hsh3167/amr_project/design_state.md

# AMR 설계 상태 — Rev14

이 문서와 요청에 필요한 소스만 먼저 읽는다. 긴 대화와 전체 저장소를 다시 분석하지 않는다. 실행 방법은 `docs/build123d-workflow.md`, 부품 출처/버전 한계는 `docs/vendor-cad.md`에 있다.

## 구성·좌표

- mm, X오른쪽/Y전방/Z위, 지면Z0. 2WD 차동구동 + 캐스터4개. **Rev12: 6륜 각각 독립 경첩+스프링 서스펜션**(핀 축 +Y, 전후진 대칭). Rev10(시소)·Rev11(레일)은 사용자 결정(2026-11-12: 독립·단순·소형)으로 대체.
- 하판390×530×**t3 강판**/Z117~120, 상판420×550×**t3 강판**/Z283~286(Rev09a: 윗면Z120·상판 밑면Z283 기준 유지), 하판 휠 웰 안쪽 X±175(Rev12, 기존±145), 트랙422, 구동륜 중심X±211/Y0/Z90. 상판은 Rev07 대비 20mm 낮췄다.
- 캐스터 스위블 중심X±138/Y±215, 휠 축Z32/오프셋Y-22. 공식 EUS CAD 장착면Z83. 카탈로그82와 실물 차이 미확인.
- LiDAR: (-220,250),heading-45° / (220,-250),heading135°, 스캔면Z240.83 가정. 광학 원점/ROS TF는 미검증.
- 카메라: X±90/Y278/Z267, yaw±15°/하향10° 가정. 상판과의 여유를 위해 카메라와 어댑터를 8mm 내렸다. Al프로파일8개: 주163mm×4 + LiDAR 지지×2 + 카메라 행거28mm×2(Rev09 구동 서스펜션 지주40mm×4 삭제). 범용20×20 단면.
- 로봇암용 상판/보강/임시124mm 홀 피치는 `payload_interface` 그룹. 6축 암 모델·하중·정격 반력·볼트 패턴은 미선정.

## 구매품

| 부품 | 확인된 사양·데이터 | 한계 |
|---|---|---|
| ZLLG65ASM250-N V2.02 ×2 | 수신23p PDF: Ø180±2, 폭42.5±1, 축방향89.8±1, Ø14/AF10/M14×1.5, NBR. 24V/18–30V,4Nm/500rpm/10A,스톨11.7Nm/30A,1024라인 | 케이스Ø140 가정, 정확한 제조사 STEP 미확보, 사양서 본문/도면표 충돌은 기존 검토문서 유지 |
| GL-65-ASF ×4 | 공식 GL-65-ASF-EUS STEP3솔리드. CAD높이83/판48X×65Y/홀24X×54Y | 보유품 EUS/TUN 및 카탈로그H82와 차이 확인 |
| SICK TiM571-2050101 ×2 | 기구 검토는 공식 치수도 엔벨로프76.25×74.39×101.12,270°,9–28V. 웹 외형은 SICK TiM5xx 공용 STL | 공개 CAD 다운로드는 EPLAN. 품번 1075091의 기구 STEP과 로그인 후 AAS 제공 여부 미확인 |
| Astra Mini Pro MX6000 A V1.2 ×2 | 공식 제품군 STEP V0.1/20221012,58솔리드. 2D V1.2:84.9×20×19.92REF,2×Ø2.2/M2 피치80 | 3D 깊이24.264와 차이. 3개 열린 참고 셸 제외. 구매품 라벨/마운트 확인. STEP 재불러오기 공차 정규화 필요 |

## 구현·설계 결정

- build123d0.12.0/OCP7.9.3.1.1, Python3.10 가상환경 `.venv`. 기존 글로벌 CadQuery2.5.2 환경은 분리 보존.
- `cad/parameters.py`가 공통 JSON을 읽고 `parts/`의 독립 생성 함수, `assembly.py`, `export.py`, CLI `python -m cad`로 조립/출력. `cad/amr_layout.py`는 새 기본 엔진의 호환 진입점.
- `--part`로 필요한 그룹만 생성, `--format none/step/stl/glb` 선택, `--individual` 개별 출력. `param` 명령/JSON 편집은 AI 없이 사용. `--pose LEFT=10`/`RF=-5` 등 6륜 각각(구동 휠 중심±10, 캐스터 장착 중심±5; 경첩 회전).
- 각 모듈: 3t U 절곡 브래킷(하판 밑)+3t 절곡 암+8t 평판 보스(Rev14)+CLBKHM10 핀(귀 고정)+MPFZ10-10 플랜지 무급유 부시2(암 Ø14 H7 압입)+스프링(암↔하판 밑면 직결)+M8 스터드(하판 위 너트=처짐 스토퍼)+C-USLH10 우레탄 스토퍼+M6 받침 볼트(범프 스토퍼, Rev12b)+예압 심. 구동: 핀X±81/Z95, 암130mm(측벽Y±36.5~42.5), CLBKHM10-78.5(Rev12a), X-SWU21-70(X±155/Y−25, 간격45·심5, 레버비0.569), 모터 축 끝벽X±167~173. 캐스터: 핀=캐스터 안쪽90mm/Z99.5, CLBKHM10-75, X-SWU17-35(캐스터 안쪽25mm—주 기둥 회피, 간격28·심5, 레버비0.722), 범프 볼트 안쪽50mm. 용접·레일·베어링·행거 없음, 가공 판금12개(3t)+평판14개 약2.9kg(Rev14). **Rev12a(2026-11-13) 구동 암 소형화:** 트레이 옆벽→핀 날개(핀 앞25)+축 끝벽±20, 암 Y−42.5~+21 비대칭, 범프 볼트 X±130/Y−25, 핀 CLBKHM10-78.5, 브래킷 볼트 Y−25/+5. 구동 암0.87→0.48kg, 모듈 폭108.5→87mm. 높이(스프링·캐스터 스택)와 X 길이는 유지. [구조·치수](docs/suspension-misumi.md) · [BOM](bom/suspension_misumi.csv)
- **Rev14(2026-11-14) 3t 절곡 제한·LiDAR 고정:** 제작 조건 "절곡 3t까지"에 맞춰 서스펜션 암·브래킷을 3t 절곡으로 바꾸고 두꺼운 부분은 평판(8t 보스, 3t 토크판)을 볼트 체결했다. 캐스터 암에 판 위 넓은 패드를 둬 볼트 구멍이 가장자리로 터지던 문제를 없앴다. 볼트는 너트 위 2mm(CB5-12, CB6-12). LiDAR는 단일 볼트 받침 기둥 대신 주기둥 두 면을 감싸는 3t 절곡 브래킷 + T너트 M5 4개로 고정(3g 처짐 0.03mm 계산). 핀·스프링 길이·하중은 그대로. [상세](docs/suspension-misumi.md)
- **Rev13(2026-11-14) 체결·지지 재점검:** 떠 있거나 체결이 없는 부품을 모두 고쳤다. 기둥 8개(주4·LiDAR2·카메라 행거2)는 양끝을 CB5-12로 판을 관통해 프로파일 중심 탭(M5)에 체결하고 하부 코너판(체결 없는 사각판)은 삭제했다. 캐스터 판 볼트 CB6-16은 OEM STEP 실측 판 두께 2mm 밑면에 머리가 닿게 바꿨다(기존 5mm 가정으로 3mm 떠 있었음). LiDAR 받침 기둥을 X±176/Y±220으로 옮겨 브리지가 주기둥을 피하고 받침 기둥에 볼트로 고정된다. 드라이버·PCB·컴퓨터(PCB 위 10mm)·전원부는 M4 스탠드오프, 배터리는 고무 패드 위에 둔다(끈은 미표시). 카메라는 90×74 어댑터판 위 10° 쐐기에 얹는다(M2 나사 미표시). 상판 보강판은 M8 4개로 체결. 검증에 접촉 연결 검사(모든 부품이 하판까지 접촉으로 이어짐, 간격 0.2mm 이하)를 추가했다.
- **Rev12b(2026-11-14) 상세화:** 범프 스토퍼를 MISUMI C-USLH10(우레탄, D10·높이17·M5 나사7)으로 교체해 암에 M5로 고정하고, 하판 관통 M6 볼트가 끝을 받는다(볼트로 높이 조정). 핀·부시·C-USLH10은 MISUMI 제공 STEP 형상을 그대로 조립(`misumi_step_exact`), 스프링은 STEP 사각 선재 단면·피치로 표시. 암 부시 구멍 입구 0.5×45° 모따기, 핀 고정 나사는 M6 탭 최소경으로 체결 표현. 전체 부품 쌍 간섭 검사를 검증에 추가하고, 하부 코너판·LiDAR 브리지·SICK 외곽·스프링 시트 간섭을 고쳤다(Rev05 기준 부품은 그대로). [상세](docs/suspension-misumi.md)
- 설계 질량 55kg(20kg 암 포함)/35kg(암 없음, 심 제거). 추정 접지: 구동127N(108~143, 바퀴 강성1.75N/mm, Rev12a 비현가 추정3.45kg)/캐스터71N(51~87, 3.63N/mm), 55kg 침하+0.7mm, 35kg 심 제거−2.9mm. 끝 기울기 구동4.4°·캐스터3.2°. MISUMI CK68(스프링)·p1_065(CLBKHM D10 L25~100 0.1단위) PDF를 2026-11-12 확인.
- 수직 이동은 기울어지는 힘을 받는 가이드(레일 또는 긴 부시)가 바퀴마다 필요해 복잡하고, 판스프링·볼트 매달기 방식은 비틀림·끼임으로 부적합해 경첩을 채택. Rev09 부시 가이드는 스톨 토크에서 굳을 위험. 2026-11-14 재검토: 핀 축이 진행 방향과 나란해 턱·경사의 앞뒤 힘은 암을 돌리지 않고(수직 이동과 동일), 단점은 좌우 기울기(구동 4.4°·캐스터 3.2°)·캐스터 좌우 이동 3.6mm·옆힘 하중 변화(1N당 0.73/1.1N)다. 수직 가이드는 마찰이 스프링 하중 변화(±18N)보다 커질 수 있어 경첩 유지. [검토](docs/suspension-misumi.md) 모터 축 스택(와셔·M14 너트·4.9mm 시험 스페이서) 유지.
- 구동 서스펜션과 간섭을 피하려 드라이버 공간Y85→125. 나머지 주요 배치는 유지. 전장/배터리는 공간예약 더미.
- 카메라 배치 BRep를 소스/코드/자세 해시별 `output/cache/`에 저장. 원본은 무손실 gzip 보관하고 SHA256 기록. STEP 수치 공차 문제를 숨기지 않고 원본 불러오기와 카메라에 한정한0.00001mm 공차 복원 후 결과를 분리 기록한다.
- FreeCAD는 STEP→검토 FCStd 매크로를 제공한다. 웹 GLB는 선형0.4mm/각도0.35rad에서 같은 부품과 재질의 면을 묶는다. WebGL은 화면이 바뀌거나 주행 애니메이션이 실행될 때 그린다. 캐시 재불러오기 시 솔리드 조립 트리를 복원한다.
- 웹 뷰어에서 LiDAR 수평 270°/사각 90°와 Astra Mini Pro 깊이 58.4°×45.5°를 각각 표시한다. LiDAR는 설계 스캔면, 카메라는 모듈 중심과 공칭 장착각을 사용한다. 표시 길이는 LiDAR 240mm, 카메라 280mm이며 실측 탐지거리와 가림은 별도 검증 대상이다. [Orbbec 사양서](https://www.orbbec.com/wp-content/uploads/2023/04/ORBBEC_Datasheet_Astra-Mini-Pro-1.pdf)

## 검증·기준

- **Rev14(3t 절곡) 178개 부품·413개 솔리드**: 형상 유효성, pytest 18개, Rev05 85개 부품 비교 통과. 정지 자세 320쌍·바퀴 끝 12자세 690쌍·6륜×5자세 474쌍·캐스터 선회 96자세 128쌍 간섭0, 접촉 연결 247접촉·미지지 부품0. 55kg 정적 평형은 Rev12와 같다(침하 +0.7mm, 구동 127N, 캐스터 71N). 강도는 단순 정적 계산만(3g 최대 약 70MPa, 캐스터 판 앞 바닥 단면).
- **Rev13(체결·지지) 156개 부품·355개 솔리드**: 형상 유효성, pytest 17개, Rev05 85개 부품 비교 통과. 정지 자세 254쌍·바퀴 끝 12자세 504쌍·6륜×5자세 326쌍·캐스터 선회 96자세 128쌍 간섭0. 접촉 연결 검사 209접촉, 미지지 부품0(GL-65 포크-판 0.87mm는 OEM STEP에 볼 베어링이 없어 예외 연결). 체결 강도·조임력은 미검증.
- **Rev12b(MISUMI STEP 상세화) 147개 부품·317개 솔리드**: 형상 유효성, pytest 15개(Rev12b 회귀 1개 추가), Rev05 85개 부품 비교 통과. 새 전체 간섭 검사: 정지 자세 전 부품 224쌍, 바퀴별 상하 끝 12자세(스프링·스토퍼 포함) 488쌍 간섭0. 기존 6륜×5자세 326쌍, 캐스터 선회 96자세·128쌍 간섭0. GL-65 제조사 STEP 내부 허브-포크 겹침 26mm³는 예외로 기록. 우레탄 압축·강도·스프링 하중은 계산·실측 검증 전.
- **Rev12a(구동 암 소형화) 141개 부품·305개 솔리드**: 형상 유효성, pytest 14개(Rev12a 회귀 1개 추가), Rev05 85개 부품 비교 통과. 6륜×5자세=30개 표본·326쌍, 캐스터 선회·상하 96자세·128쌍 BRep 간섭0. 새 범프 볼트 위치에서 처짐 너트·범프 볼트 접촉 테스트 통과. 암 강도는 단순 정적 계산(3g 굽힘 약47MPa, 정지 토크 비틀림 약11.5MPa)만.
- **Rev12(부시 추가) 141개 부품·305개 솔리드**: 형상 유효성, 기하 테스트13개, Rev05 85개 부품 양방향 차집합 통과. 6륜×5자세=30개 표본·326쌍, 캐스터 선회·상하 96자세·128쌍 BRep 간섭0. 서스펜션 80부품을 공칭 자세에서 전체 부품과 별도 교차 검사(간섭0). 각 암이 처짐 너트·범프 볼트에 정확히 닿고 넘으면 간섭, 부시는 암과 함께 움직이고 핀과 겹치지 않음을 테스트. STEP 일반 재불러오기 false(카메라)/정규화 후 true. 웹 뷰어 6륜 포즈·오류0. 강도는 단순 계산만. Rev11 레일안 검증은 커밋 5c308b1.
- Rev09 159개 부품·337개 솔리드. 기하 테스트 13개, Rev05 기준 85개 부품 비교, 상하 30개 및 선회·상하 조합 96개 간섭 표본 통과. 로커 양쪽 스토퍼가 설정 범위를 제한하는지 확인했다. 150N 수직·75N 수평의 가정 하중에서 암 단면 단순 휨 약 125MPa. 시제품 충격·피로 검증은 남아 있다.
- CAD 체적과 강철 밀도 7.85g/cm³로 추정한 캐스터 가공 강판 부품은 4개 모서리 합계 약 3.83kg으로 Rev08의 약 2.78kg보다 1.05kg 증가했다. 레일·핀·부시·체결품과 구매 캐스터를 제외한 비교다.
- Rev08 167개 부품·357개 솔리드. 기하 테스트 13개와 Rev05 양방향 차집합 비교 통과. 상하 30개 자세와 캐스터 선회·상하 96개 표본에서 간섭이 없었다. 상판 밑면은 카메라 최고점보다 약 4.32mm 위이고, 최저 카메라 어댑터는 LiDAR 설계 스캔면보다 11.17mm 위다.
- Rev07 전체 191개 부품·365개 솔리드, 서스펜션 단독 STEP 136개 부품. 테스트 12개 통과. 상하 이동 30개와 캐스터 선회·상하 조합 96개 표본에서 간섭 0건. 스프링 길이·변형 여유·하중 추정치는 `build_report.json`의 `suspension_catalog`에 기록한다. [GitHub 자동 생성 결과](https://github.com/hsh3167/amr_project/actions/runs/43217610583)
- 복원 브랜치 `backup/cadquery-rev05-20261111`, 기준 커밋 `61483e8`, `cad/baseline/rev05/` STEP/JSON 보존. `cad/amr_layout_cadquery.py`는 기준 JSON에 고정한 기존 코드. 기존 CadQuery 재생성 통과.
- **순수 엔진 전환85부품:** 이름별 경계/질량중심/체적/솔리드 수/양방향 차집합 모두 통과. 최대 경계오차8.62e-11mm, 체적차2.06e-7mm³, 차집합0mm³. `comparison_build123d.json` 참조.
- 공식 캐스터3솔리드/H83, 6륜 공칭접지와 독립 자세, 개별 STEP 재불러오기와 Rev07 스프링 카탈로그 장착 길이를 자동 검사한다.
- 99개 관련 부품 대상으로 6륜×5자세=30개 표본,84개 후보 쌍의 실제 BRep 교차 검사에서 간섭0. 연속 스위프/스프링 및 접합부 내부 간섭의 전수 검증은 아님.
- Rev05 변환 STEP의85솔리드 유효성/FCStd 저장 완료. **Rev06 117개 논리 부품/231솔리드**의 유효성/양의 체적/6륜 접지/Ø180×42.5/축 AF10·전체89.8/수량2·4·2·2/스캔면 상하 여유/1616개 LiDAR 표본/선별 간섭 검사 통과. 전체 STEP/STL/GLB와117개 개별 STEP/STL 생성 완료.
- STEP 일반 재불러오기 유효성은 **false**. 카메라2개에 한정한 위상 공차0.00001mm 복원 후 **true**,231솔리드 유지, 공차 복원에 의한 체적 변화0. `build_report.json`은 두 결과를 구분한다. 원본 STEP 자체가 모든 프로그램에서 무보정 유효하다고 주장하지 않는다.
- FreeCAD1.1.4에서 Rev06을 GUI/명령행으로 불러와 카메라14솔리드의 위상 공차를 복원한 뒤231솔리드 유효성 확인 및 `output/freecad/amr_review.FCStd` 저장, GUI 검토 이미지 확인 완료. 매크로는 잘못된 다른 부품을 무조건 복구하지 않는다.
- GitHub 자동 생성 [43027928282](https://github.com/hsh3167/amr_project/actions/runs/43027928282) 통과. [공개 뷰어](https://hsh3167.github.io/amr_project/?rev=06)에서 117개 부품 표시, 상판 숨기기, 바퀴별 스트로크 조작과 STEP 다운로드 응답을 확인했다.

## 미해결·다음 작업

1. 시제품 저울로 55kg에서 구동 약128N·캐스터 약71N 확인, 심·스터드 너트·범프 볼트로 조정(암 없으면 심 제거). 부시 압입·핀 고정·축방향 유격, 6t 절곡·구멍 정렬, 범프 충격, 감쇠 부족(댐퍼 없음) 검증. 구동축 숄더·와셔·너트 실제 스택 확인. MISUMI CAD·가격·납기는 2026-11-14 확인: 핀·부시·C-USLH10은 STEP 그대로 조립(Rev12b), MISUMI 품목 합계 212,580원 + 표준품·판금 추정 293,160원 = 서스펜션 예상 505,740원(VAT 별도, 공개 뷰어 BOM). 판금 가공·표준품 견적, 실물 공차·열처리, C-USLH10 우레탄 충격 흡수량은 미확인.
2. 캐스터83/82 차이와 suffix, 카메라3D/2D/보유품 버전·어댑터, 모터 케이싱·배선 실측. 일반 STEP 불러오기에서 카메라 수치 공차를 별도 복원해야 하는 호환성 문제.
3. 다음 단계: 앞 캐스터와 구동륜을 보기 링크로 묶는 구조를 새로 만든다. 사용자가 보유 부품을 제공한 뒤 설계한다(준비 문서 [bogie-link-prep](docs/bogie-link-prep.md)). 현재 Rev14는 그대로 둔다.
4. 7S9P 화학종/셀/BMS/실측 크기·드라이버 선정. 4.2V계7S 완충29.4V는 모터30V까지0.6V만 남음. 회생·클램프·BMS 함께 검토. 모터18–30V를 드라이버 정격으로 간주하지 않음. TiM571 최대28V에는 안정화24V 사용.
5. 3t 하판·상판은 프로파일 보강 없이 강도 부족(상판 163MPa/0.49°, 하판 2g 156MPa). 하판 종방향 레일·상판 2040 프레임을 Rev12 경첩 브래킷·스프링·스토퍼 위치와 함께 배치해야 한다. [판·서스펜션 검토](docs/plate-suspension-review.md)
6. 실제 암 선정 후 지지다각형/전도·상판 휨/접합 강성/동하중 검증. 현재 모델은 제작 승인 상태가 아님.
