hsh3167/amr_project/docs/suspension-misumi.md

# AMR 서스펜션 · Rev14 (6륜 독립 경첩 + 스프링, 3t 절곡 제한)

2026-11-12 사용자 결정: 6개 바퀴 모두 독립 서스펜션이고, 구조는 **단순하고 작아야** 한다. 수직 레일(Rev11)은 기울어지는 힘을 받을 가이드가 바퀴마다 필요해 부품이 많았다. 경첩은 핀 하나가 모멘트를 모두 받으므로 가이드가 필요 없어 가장 단순하다. 이전 개념은 git 이력에 있다: Rev09 `4643d47`, Rev10 `a5f5081`, Rev11 `5c308b1`.

## Rev14 3t 절곡 제한 반영 (2026-11-14)

제작 조건: **절곡은 3t까지만 가능**하다. Rev13의 6t 절곡 암과 4.5t 절곡 브래킷은 만들 수 없어 바꿨다. 두꺼운 부품은 절곡 없는 평판으로 만들어 볼트로 체결한다. 핀(CLBKHM10-78.5/-75)과 MISUMI STEP은 그대로다.

| 부품 | Rev13 | Rev14 |
|---|---|---|
| 구동 암 | 6t 바닥 + 핀 날개 + 끝벽 | 3t 채널: 바닥 + 전체 길이 옆벽 2개 + 끝벽(절곡 3회), Y −44~+22.5, 바닥 Z69~72(스프링 자리 Z72 유지) |
| 캐스터 암 | 6t 바닥 + 날개 2개, 폭 ±30 | 3t: 좁은 바닥(±31.5) + 옆벽 2개(절곡 2회) + 캐스터 판 위 넓은 패드(±37.5). 판 볼트 구멍 가장자리 거리 7mm(Rev13은 구멍이 암 옆면으로 터짐) |
| 부시 자리 | 6t 암에 직접 압입 | 옆벽 안쪽 **8t 평판 보스**(절곡 없음)에 압입, CB4-10 2개로 옆벽에 체결. 보스는 브래킷 귀(핀±12)를 피해 핀에서 18mm 바깥에 나사 |
| 구동축 토크 | 6t 끝벽 슬롯 | 3t 끝벽 + **3t 평판 토크판**(AF10.2 슬롯, 축 너트로 함께 조임) = 6mm, 축 스택 위치 그대로 |
| 힌지 브래킷 | 4.5t U | 3t U(절곡 2회) |
| 스프링 자리 | 6t 바닥 윗면 | 구동: 바닥 Z를 3 올려 그대로. 캐스터: 3t 바닥 + **고정 스페이서 3mm**로 그대로(스프링 길이·하중 변화 없음) |
| 스터드 / 스토퍼 | 6t 탭 | 3t 바닥에 M8 탭 + 나사 고정제(처짐 하중 100N 미만). C-USLH10은 3t 바닥 + M5 너트 4 = 나사 7 |
| 볼트 길이 | CB5-14, CB6-16(너트 위 3~4mm) | CB5-12, CB6-12: 너트 위 2mm |

- 가공 강판 합계 약 2.9kg(구동 암 0.38kg, 캐스터 암 0.29kg, 브래킷 0.08kg, 보스 0.07kg ×2).
- 단순 정적 계산(3g 수직 충격, S355): 구동 암 스프링 위치 굽힘 약 9MPa, 정지 토크 11.7Nm 비틀림 약 28MPa(열린 단면, 축 둘레 0.6°), 캐스터 암 핀 쪽 약 17MPa, 캐스터 판 앞 바닥만 있는 단면 약 70MPa, 보스 CB4 전단 약 24MPa, 3t 귀 지압 약 14MPa. 피로·충격·절곡부 균열·실물 강성은 미검증이다.

## Rev13 캐스터 판 체결 (2026-11-14)

- GL-65 OEM STEP의 판 두께는 2mm(Z81~83, 구멍 Ø7)다. 기존 모델은 5mm로 가정해 CB6-16 머리가 판 밑 3mm에 떠 있었고 선회 레이스 위에 얹혀 있었다. 머리를 판 밑면(Z81)에 붙였다. 판 2 + 암 6 + M6 너트 5 + 나사 3 여유이고, 머리 아래 선회 레이스와 3mm 간격이 있다.

## Rev12b 상세화·간섭 정리 (2026-11-14)

- **범프 스토퍼를 MISUMI `C-USLH10`(경제형 우레탄 스토퍼, 수나사)으로 바꿨다.** D10, 높이 17, M5×0.8 나사 7, 쇼어 A90. 암 바닥(6t)에 M5 탭으로 세우고, 하판을 관통한 M6 볼트(잼너트로 높이 조정)가 끝을 받는다. 우레탄 높이 17로는 암과 하판 사이(구동 45, 캐스터 28)를 채울 수 없어 볼트를 받침으로 남겼다. 나사 7이 6t 암 밑으로 1mm 나온다.
- 핀(CLBKHM10-78.5/-75), 부시(MPFZ10-10), C-USLH10은 MISUMI가 제공한 STEP 형상을 그대로 조립에 넣었다(`misumi_step_exact`). 스프링 STEP은 자유 길이 형상이라 그대로 쓰지 않고, 모델 스프링을 STEP의 사각 선재 단면(구동 3.75×1.875, 캐스터 3.25×1.625)과 피치(감김 8.75/4.75)로 바꿨다. 끝단 연마 코일은 생략했다.
- 핀 끝 M6 탭(최소경 4.92)에 맞춰 고정 나사 CB6-8의 체결부를 최소경으로 그렸다. 부시 슬리브와 플랜지 사이 R0.3 필렛이 암 구멍 모서리와 겹쳐, 암의 부시 구멍 입구에 0.5×45° 모따기를 넣었다.
- 전체 부품 쌍 검사(정지 자세 + 각 바퀴 상하 끝, 스프링 포함)에서 기존 검사가 보지 않던 간섭을 찾아 고쳤다: 하부 코너판이 3t 하판에 1mm 묻힘 → 판 위로 올리고 기둥 구멍(20.4 각)을 뚫음, 코너판과 LiDAR 기둥 겹침 → 27 각으로 축소, LiDAR 브리지가 주기둥을 관통 → 기둥 자리 노치, SICK 광학 외곽과 상부 원판 겹침 → 외곽 높이 3 축소, 자세별 스프링과 예압 심 겹침 → 기울어진 시트의 높은 쪽에 스프링을 맞춤. GL-65 캐스터 제조사 STEP 안에서 바퀴 허브가 포크 다리에 0.2mm 들어가는 겹침(26mm³)은 원본 그대로 두고 예외로 기록했다.
- Rev05 기준 부품(`--variant baseline`)은 바꾸지 않았다.

## Rev12a 소형화 (2026-11-13)

높이는 줄이지 않았다. 캐스터는 캐스터 높이 83 + 암 6 + 스프링 간격 28 = 하판 밑면 117로 고정이다. 구동 스프링은 CK68에서 짧은 형번(X-SWU21-60은 간격 −5.7mm·압축 여유 1.6mm, X-SWR21-45는 −7.4mm·접지하중 약 86~170N)을 검토했으나, 바닥 높이에 따라 구동륜 접지하중이 크게 흔들려 X-SWU21-70을 유지했다. 캐스터 암 단축(90→70)과 구동 암 단축(130→110)은 끝 기울기와 하중 변동이 커져 채택하지 않았다.

| 항목 | Rev12 | Rev12a |
|---|---|---|
| 구동 암 형상 | 바닥 + 전체 길이 옆벽 2개 + 끝벽 ±42.5 (트레이) | 바닥 + 핀 근처 날개 2개(핀 뒤 12, 앞 25) + 축 끝벽 ±20. 절곡 3회 동일 |
| 구동 암 폭(Y) | −42.5~+42.5 대칭 | −42.5~+21 비대칭(−Y: 스프링·범프 스토퍼, +Y: 부시만) |
| 구동 범프 볼트 | X±140, Y+20 | X±130, Y−25 (스프링과 같은 줄, 배터리 모서리와 7.5mm) |
| 구동 핀 | CLBKHM10-100 (카탈로그 최대) | CLBKHM10-78.5 |
| 구동 브래킷 볼트 | Y±25 | Y−25, +5 |
| 구동 모듈 외곽(Y) / 부품 부피 | 108.5mm / 158cm³ | 87mm / 104cm³ |
| 구동 암 질량 | 0.87kg | 0.48kg |
| 가공 판금 12개 합계 | 약 4.3kg | 약 3.4kg |

- 단순 정적 계산(6t 바닥 85mm 폭 기준): 3g 수직 충격에서 스프링 위치 굽힘 약 47MPa, 모터 정지 토크 11.7Nm에서 바닥 비틀림 약 11.5MPa·0.14°. 부시 간격이 85→63.5mm로 줄어 견인 모멘트에 의한 부시 하중이 약 34% 늘지만 투영 면압은 수 MPa 수준이다. 피로·충격·절곡부·실물 강성은 미검증이다.
- 옆벽이 없어져 하판 밑 Z97~117에서 구동 모듈을 가로지르는 X≈107~133 띠가 비었다. 하판 종방향 레일 후보 통로이지만, 캐스터 구간(Y±178~260)에서는 캐스터 스터드(X±113)·캐스터 판 볼트와 겹치므로 레일 길이나 캐스터 스프링 위치를 함께 정해야 한다(미검토).

## 모듈 (6개 모두 같은 구조)

| # | 부품 | 비고 |
|---|---|---|
| 1 | 3t U 절곡 브래킷 | 하판 밑면에 CB5-12로 고정. 두 귀 구멍은 절곡 후 함께 리밍 |
| 2 | 3t 절곡 암 + 8t 평판 보스 2개 | 바퀴/캐스터를 단다. 바닥 + 옆벽(구동은 끝벽 + 3t 토크판). 스프링 자리에 M8 탭 |
| 3 | MISUMI `CLBKHM10` 힌지 핀 + `MPFZ10-10` 플랜지 무급유 부시 2개 | 핀은 귀(Ø10 H7)에 고정. 부시는 암의 Ø14 H7 구멍에 바깥에서 압입하고 핀 위에서 돈다. 플랜지(Ø22×2)는 귀와의 스러스트 와셔. M6 나사로 핀 빠짐 방지 |
| 4 | 스프링 1개 | 암 윗면과 **하판 밑면 사이에 바로** 둔다(행거 없음) |
| 5 | M8 스터드 + 너트 | 스프링을 관통한다. 하판 위 너트가 **처짐 스토퍼**(너트로 조정) |
| 6 | MISUMI `C-USLH10` 우레탄 스토퍼 + M6 볼트·잼너트 | 스토퍼는 암에 M5로 고정하고, 하판을 관통한 M6 볼트 끝이 우레탄 끝을 받는 **범프 스토퍼**(볼트로 높이 조정) |
| — | 5mm 예압 심 | 로봇암이 없을 때 뺀다 |

- 핀 축은 모두 진행 방향(Y)과 나란하다. 그래서 견인·제동력과 턱 반력의 앞뒤 성분이 암을 돌리지 않아 **전진·후진 거동이 같다**.
- 용접, 레일, 볼베어링, 행거가 없다. 주문 가공품은 레이저 절단·절곡품 12개(암 6, 브래킷 6, 모두 3t)와 평판 14개(보스 12, 토크판 2)이고, 강판 합계 약 2.9kg이다(Rev14).
- 하판 휠 웰 안쪽 경계를 X±145에서 ±175로 바꿨다(모터 케이스 안쪽 면 X±177.9). 구동 스프링이 하판 밑에 바로 들어가도록 하기 위해서다.

## 치수와 하중 (55kg, 무게중심 중앙)

| 모듈 | 핀(축 위치) | 암 길이 | 스프링 | 레버비 | 스트로크 / 끝 기울기 | 처짐 · 공칭 · 범프 접지하중 |
|---|---|---|---|---|---|---|
| 구동 ×2 | CLBKHM10-78.5 (X±81, Z95) | 130mm | X-SWU21-70 (X±155·Y−25), 장착 40mm(간격45·심5) | 0.569 | ±10mm / 4.4° | 108 · **126** · 143N (Rev12a 비현가 3.45kg 추정) |
| 캐스터 ×4 | CLBKHM10-75 (캐스터 안쪽 90mm, Z99.5) | 90mm | X-SWU17-35 (캐스터 안쪽 25mm), 장착 23mm(간격28·심5) | 0.722 | ±5mm / 3.2° | 51 · **69** · 87N |

- 스프링은 MISUMI CK68, 핀은 p1_065(D10, L25~100, 0.1mm 단위), 부시는 p1_383(MPFZ d10: D14 m6, 플랜지 Ø22, L10~30, 하우징 14 H7)에서 2026-11-12에 확인했다. 부시 플랜지 자리 2.5mm를 둔다. Rev12a 구동 핀 날개 바깥면은 Y−42.5/+21이고 핀은 L78.5다. 스프링 허용 변형 여유는 구동 2.8mm, 캐스터 3.6mm(허용 변형 55%L=19.25, 2026-11-14 수정)이고, 하중 공차는 ±10%다.
- 바퀴 기준 강성은 구동 1.75N/mm, 캐스터 3.63N/mm다(합계 18.0N/mm). 구동륜은 바닥 높이가 변해도 접지하중이 108~143N으로 거의 일정하다(견인력 확보).
- 캐스터 스프링과 스터드를 캐스터 바로 위가 아니라 안쪽 25mm에 둔 이유는, 하판 윗면의 주 프로파일 기둥(X±146, Y±208)을 피하기 위해서다. 범프 볼트는 LiDAR 지지 기둥을 피해 캐스터 안쪽 50mm에 둔다.
- 정적 평형:

| 조건 | 차체 침하 | 구동륜당 | 캐스터당 | 구동 하중비 |
|---|---|---|---|---|
| 55kg, 심 있음 | +0.7mm | 127N | 71N | 47% |
| 35kg, 심 제거 | −2.9mm | 106N | 33N | 61% |
| 35kg, 심 유지 | −10.2mm (한계 초과) | — | — | — |

- 캐스터 하중은 선회 방향에 따라 달라진다. 접지점이 경첩에서 68~112mm 사이에서 움직이기 때문이다.
- 단점은 두 가지다. 첫째, 끝 자세에서 바퀴가 기운다. 구동은 4.4°이고 타이어 가장자리가 휠 중심보다 1.35mm 더 내려가며, 캐스터 선회축은 3.2° 기운다. 평소 ±3mm 안에서는 구동 1.3°, 캐스터 1.9° 수준이다. 둘째, 옆방향 힘이 경첩 높이 때문에 접지하중을 조금 바꾼다.

## 구조 검토: 경첩 vs 수직 이동 (2026-11-14)

질문: 바퀴가 수직이 아니라 호를 따라 움직이므로 경사·턱에서 문제가 생기지 않는가, 수직 이동 구조가 더 낫지 않은가. 결론은 **경첩 유지**다. 아래 값은 현재 CAD 형상(구동 핀 X±81/Z95·암 130, 캐스터 핀 Z99.5·암 90)으로 계산한 준정적 값이며 실물 시험 전이다.

- **진행 방향(턱·경사)**: 핀 축이 진행 방향(Y)과 나란해 바퀴 궤적은 좌우 평면(XZ)에 있다. 턱이나 경사에서 받는 앞뒤 힘과 견인·제동력은 핀 축과 평행이라 암을 돌리지 않는다. 바퀴를 올리는 것은 수직 성분뿐이므로 이 방향의 거동은 수직 이동 구조와 같다. 턱에서 바퀴가 비스듬히 밀려 걸리거나 전후진 거동이 달라지는 문제는 핀 축이 좌우(X)인 트레일링/리딩 암의 특성이며, 이를 피하려고 이 방향을 택했다.
- **좌우 방향 부작용**(실제로 있음):

| | 구동륜 (+3 / +10mm) | 캐스터 (+3 / +5mm) |
|---|---|---|
| 바퀴(선회축) 기울기 | 1.3° / 4.4° | 1.9° / 3.2° |
| 바퀴 중심 좌우 이동 | 0.1 / 0.0mm (거의 수직) | 2.2 / 3.6mm (수직에서 약 35°) |
| 접지점 좌우 이동 | 2.2 / 6.9mm | 3.3 / 5.4mm |
| 옆힘 1N당 접지하중 변화 | 0.73N | 1.1N |

  캐스터는 핀이 바퀴보다 67mm 높아 경로가 수직에서 기운다. 행정이 ±5mm라 절대량은 수 mm다. 5° 횡경사에서 구동륜 하중 변화는 약 6%다.
- **수직 이동의 약점**: 가이드가 견인력과 모터 정지 토크(11.7Nm)를 굽힘 모멘트로 받아, 가이드 반력의 미끄럼 마찰이 수십 N 수준이 된다. 행정 전체 스프링 하중 변화가 구동·캐스터 모두 약 ±18N이므로 견인력이 클 때(턱·경사) 가이드가 걸려 서스펜션이 굳을 수 있다. 경첩은 반지름 5mm 부시 마찰이 암 길이로 줄어 바퀴 환산 약 1.2~1.5N이다(μ0.15 가정). Rev09 부시 가이드(정지 토크에서 굳을 위험)와 Rev11 레일(바퀴마다 가이드 필요)에서 확인한 문제와 같다.
- **턱 넘기 한계는 바퀴 지름이 정한다**: 밀어야 하는 힘/하중은 Ø64 캐스터 5mm 0.64, 10mm 1.06, 15mm 1.59배, Ø180 구동륜 20mm 0.81, 30mm 1.12배다. 경첩·수직과 무관하며, 현재는 10mm 문턱 정도가 현실적 한계로 본다.
- 진행 방향과 나란한 축의 경첩은 AMR에서 흔한 형태는 아닌 것으로 보이나 제품 자료로 확인하지 않았다.
- 시제품 시험: 10·15mm 턱 넘기(전진·후진), 경사로 주행, 횡경사 제자리 회전에서 캐스터 좌우 이동·선회 거동과 구동륜 하중 변화를 확인한다.

## 남은 확인 사항

1. 부시 압입(Ø14 H7, 캐스터 탭은 구멍 위아래 살 3.5mm)과 압입 후 내경, 부시 슬리브가 판 안쪽으로 2mm 돌출하는 것, 핀 고정(귀 H7)과 축방향 유격을 확인한다.
2. 시제품 저울로 구동 약 128N, 캐스터 약 71N(55kg)을 확인한다. 심, 스터드 너트, 범프 볼트로 조정한다.
3. 6t 절곡(굽힘 반경), 암 탭 구멍과 귀 구멍의 정렬, 볼트 체결, C-USLH10 우레탄의 범프 충격 흡수량, 감쇠 부족(댐퍼 없음)을 검증한다. 우레탄 압축 변형은 모델에 넣지 않았다.
4. MISUMI CAD·가격·납기는 2026-11-14 kr.misumi-ec.com에서 로그인 후 확인했다(원본 `cad/vendor/*.st*p.gz`, 출처·SHA256은 `cad/vendor/provenance.json`, 가격은 [BOM](../bom/suspension_misumi.csv)).
   - STEP 실측(5개 모두 단일 유효 솔리드)이 모델 치수와 일치한다: 핀 D10·머리 Ø16×1.5·L78.5/75(플랜지 아래 기준), 부시 OD14·플랜지 Ø22×2·전체 10(슬리브 8), 스프링 OD21/ID13.5/L70, OD17/ID10.5/L35. 모델 치수는 바꾸지 않았다.
   - Rev12b부터 핀·부시·C-USLH10은 제공 STEP 그대로 조립에 들어간다(위 Rev12b 절). 스프링 강성·밀착 길이는 STEP에서 알 수 없어 카탈로그 값을 유지한다.
   - 가격(VAT 별도, 2026-11-14 사이트 조회): 핀·부시·스프링·C-USLH10·CB 나사 합계 212,580원(X-SWU21-70은 최소 주문 10개). 표준 체결품·판금 가공은 견적 전 추정 293,160원이다. 서스펜션 6모듈 예상 총액은 505,740원이며 공개 뷰어의 "BOM·예상 가격"에서 볼 수 있다. 참고 출하일은 늦은 품목 기준 2026-11-24이고, 가격·납기는 주문 전에 다시 확인한다.
6. 위 구조 검토의 시제품 시험(턱 10·15mm, 경사로, 횡경사 제자리 회전)을 한다.
5. 3t 하판·상판의 프로파일 보강은 미반영이다([판·서스펜션 검토](plate-suspension-review.md)).
