hsh3167/amr_project/docs/plate-suspension-review.md

# 판 두께·서스펜션 단순화 검토 (Rev09 기준, 2026-11-12)

CAD 형상은 바꾸지 않았다. 이 문서는 판 FEM 스크리닝 계산 결과와 단순화 제안을 정리한 것이며, 제작 승인 근거가 아니다. 계산 스크립트는 `tools/analysis/`에 있다(Mindlin 판 요소, 프로파일은 비합성 보, 편심 무시라 보수적이다. 단순지지 정사각판 중앙하중의 Roark 해와 1% 이내로 일치한다).

## 1. 하중 기준 불일치 (가장 중요)

- Rev09 스프링은 **총중량 30kg** 기준이다. CAD 체적에 강철 7.85g/cm³를 적용하면 4t 강판 2장(5.85+7.24kg), 보강판 0.93kg, 서스펜션 강재 6.16kg만 합쳐도 약 20kg이다. 모터(3.15kg×2), 캐스터, 배터리, 전장품을 더하면 **로봇암 없이도 약 33~35kg**으로 추정된다.
- 로봇암(≤20kg)과 페이로드(약 3~5kg 가정)를 올리면 총중량은 **약 55kg**이다.
- 현재 스프링으로 계산한 결과(중앙 무게중심·평지·카탈로그 강성):

| 총중량 | 차체 침하 | 구동륜 접지하중 | 캐스터 상태 | 구동륜 하중비 |
|---|---|---|---|---|
| 30kg | 0.1mm | 83N | 정상 | 57% |
| 35kg | 2.1mm | 91N | 정상 | 53% |
| 55kg | 5mm(한계) | 101N | **4개 모두 범프 스토퍼에 닿고 31N씩 강체 지지** | 37% |

→ 암을 장착하면 캐스터 서스펜션이 정적으로 바닥에 닿아 기능하지 않는다. 55kg에서 구동륜 하중비 55%를 목표로 하면 스프링 힘은 구동 약 111N, 캐스터 약 53N이 필요하다. 지금의 X-SWU17-70은 허용 변형량(38.5mm)을, X-SWU10.5-30은 16.5mm를 넘으므로 **강성 약 2배 계열로 재선정**해야 한다(목표: 구동 약 7N/mm, 캐스터 약 9N/mm). 정확한 형번은 MISUMI 카탈로그에서 확인한 뒤 확정한다.

## 2. 강판 두께

하중 가정: 암+페이로드 25kg이 중앙 4볼트(임시 124mm 피치)에 작용한다. 수직 2g(500N) 또는 정적 하중+전도 모멘트 150N·m(암 미선정 상태의 가정값)이다. 강재는 E=210GPa로 놓았다. 기준값은 SS400 항복강도 245MPa 대비 피로·구멍 응력집중을 고려한 약 80MPa 이하이고, 암 베이스 기울기 약 0.1° 수준이다. 볼트·하중점 15mm 이내의 특이 응력은 제외했다.

### 상판 420×550 (기둥 4개 (±146, ±208) 지지)

| 구조 | t | 전도 모멘트 시 최대 처짐 | 암 베이스 기울기 | σVM |
|---|---|---|---|---|
| **현재: 기둥만 + 5t 보강판** | 4 | 0.54mm | 0.23° | 73MPa |
| 기둥만 | 5 / 6 | 0.30 / 0.19mm | 0.13 / 0.08° | 47 / 33MPa |
| 2020 외곽+2020 크로스 2개 | 3.2 | 0.46mm | 0.22° | 68MPa |
| **2020 앞뒤 + 2040 좌우·크로스 2개 (권장)** | 3.2 | 0.21mm | 0.11° | 32MPa |
| 같은 구조, 보강판 제거 | 3.2 | 0.21mm | 0.12° | 36MPa |

- 현재 구조에는 상판 아래 수평 프로파일이 없다. 그래서 판 두께만으로 굽힘을 받으며, 4t에서는 강도는 견디지만 암 베이스가 0.23° 기울어진다. 판만으로 해결하려면 6t(약 10.9kg)가 필요하다.
- **권장: 상판 SS400 3.2t + 상판 하부 프로파일 프레임.** 2040 2개를 암 볼트 바로 아래에 두고, 좌우 레일도 2040으로 한다. 상판 질량은 7.24kg에서 5.8kg으로 줄고 강성은 약 2배가 된다. 보강판 5t(0.93kg)는 제거할 수 있으며, 실제 암 볼트 패턴이 정해지면 그때 어댑터판으로 대체한다. 2.3t도 계산상 성립하지만(0.14°, 47MPa) 체결부 국부 변형과 취급성을 고려해 3.2t를 최소로 본다.

### 하판 390×530 (구동휠 웰 포함, 하중 2g)

구동 요크 M5 체결점을 지지점으로 두었다. 기둥 하중(상판+암 32kg), 배터리 4kg, 전장 2kg, 캐스터 반력(현가 중량의 40%)을 하중으로 넣었다.

| 구조 | t | 최대 처짐 | 기둥 하단 처짐 | σVM |
|---|---|---|---|---|
| 판만 | 3.2 | 4.2mm | 2.8mm | 138MPa |
| **판만 (현재)** | 4 | 2.2mm | 1.5mm | 92MPa |
| 판만 | 4.5 / 6 | 1.6 / 0.7mm | 1.1 / 0.5mm | 75 / 45MPa |
| **3.2t + 2020 종방향 레일 2개 (x=±136, y±208) (권장)** | 3.2 | 0.5mm | 0.33mm | 30MPa |

- 하판은 기둥 하중(y=±208)이 구동 요크(y=±55)까지 약 150mm를 외팔보처럼 전달하고, 휠 웰 때문에 폭이 290mm로 줄어든다. 그래서 **상판보다 하판이 더 취약하다.** 현재 4t는 2g에서 92MPa로, 구멍 응력집중을 고려하면 여유가 적다.
- **권장: 하판 SS400 3.2t + 2020 종방향 레일 2개.** 레일이 기둥 하단과 구동 서스펜션을 직접 잇는다. 대안으로 구동 서스펜션 지주(현재 40mm×4)를 상판 프레임까지 연장해 구동 반력을 프레임으로 직접 보내는 방법도 있다. 다만 x=±136 부근은 배터리(±117.5), 구동 요크(130~174), 토크 캐리어(146~170)와 매우 가까워 CAD 간섭 검토가 필요하다.
- 판 2장의 합계 질량은 14.0kg에서 약 10.5kg으로 줄고, 추가 프로파일은 약 1.8kg(단위 질량은 카탈로그 확인 필요)이다.
- 3.2t는 국내 SS400·SPHC 레이저 가공의 표준 두께다. CAD 부품명 `01_lower_Al_plate`/`20_upper_Al_plate`와 문서의 Al 표기는 강판 결정과 맞지 않으므로 CAD 반영 때 수정한다.

## 3. 서스펜션 단순화 제안

> 2026-11-12 최종 결정: 6륜 모두 독립 경첩+스프링(Rev12, 핀 축 +Y). 시소(제안 B)와 수직 레일(Rev11)은 채택하지 않았다. 최신 구조는 [suspension-misumi.md](suspension-misumi.md)를 따른다.

### 현재 구조의 제작 부담
- 구동(1측): 가이드 샤프트 2개, 부시 2개, S45C 캐리어(H7 보어 2개를 같은 셋업에서 가공), 용접 요크(샤프트 시트 후가공 정렬), 텔레스코픽 파일럿, 지주 2개, 상부 시트, 스토퍼 링 4개로 가공품 약 9종이다. 휠이 가이드에서 X로 53mm 떨어져 있어 견인력·토크가 직선 부시에 모멘트를 주고, 이 때문에 끼임(stick-slip)이 생겨 서스펜션 추종을 방해할 위험이 있다.
- 캐스터(4개): 5t 암에 Ø22 슬리브 용접, 용접 클레비스, 경사 스토퍼 창이 있고 용접 후 동축 라인보링이 필요하다. 4개 합계 강재 3.83kg이다.

### 제안 A — 6륜 독립 유지, "스윙암 모듈" 하나로 통일 (권장, AGENTS 규칙 준수)
1. **구동륜도 캐스터와 같은 트레일링 스윙암**으로 바꾼다. 6t 레이저 컷 암에 모터 축 AF10 슬롯을 내 토크 반력을 암이 받게 하고, 피벗은 캐스터와 같은 `CLBKHM10` 핀과 `C-MPFZ10` 플랜지 부시를 사용한다. 피벗 높이를 축 높이(Z90)에 맞추면 견인력에 의한 들림이 작다. 암 길이를 150mm로 하면 ±10mm 스트로크에서 각도 ±3.8°, 휠 전후 이동 0.33mm다. 정격 견인력 44N에 의한 접지하중 변동은 약 ±26N으로 추정된다.
2. **용접 제거**: 클레비스는 3.2~4.5t 판을 U자로 절곡한 하나의 브래킷으로 하고, 두 귀 구멍은 절곡 후 한 번에 리밍한다. 암은 평판 레이저 컷으로 만들고, 부시가 들어갈 길이는 볼트 체결 보스나 미스미 부시 홀더로 확보한다.
3. **스프링 가이드 볼트로 스토퍼 겸용**: 스프링 속을 관통하는 볼트에 너트를 달아 처짐(droop) 한계를 정하고, 범프 측은 우레탄 스토퍼로 충격과 소음을 흡수한다. 경사 스토퍼 창, 스토퍼 링 4개, 텔레스코픽 파일럿이 모두 빠진다. 예압은 와셔·심으로 조정한다.
4. 결과적으로 6개 모듈이 같은 핀·부시·스프링 가이드·스토퍼를 공유하고, 주문 가공품은 레이저 컷 평판·절곡품 위주가 된다. 정밀 가공은 피벗 구멍 리밍만 남는다.

### 제안 B — 더 단순하지만 규칙 변경 필요
전방 캐스터 2개는 강체로 두고, 후방 캐스터 2개는 가로 진자 빔 하나(피벗 1개, 스프링 없음)에 올린다. 여기에 구동륜 스윙암 2개만 스프링을 둔다. 4개 캐스터가 3점 지지처럼 바닥을 따라가고 구동륜 접지력은 스프링이 보장한다. 산업용 AMR에서 흔한 구성이며 스프링은 2개, 피벗은 3개다. 다만 `AGENTS.md`의 "6륜 각각 독립 서스펜션 유지" 규칙과 충돌하므로 사용자가 결정해야 한다.

## 4. 남은 확인 사항
- 실제 로봇암 형번(질량·페이로드·베이스 모멘트·볼트 패턴)에 따라 전도 모멘트 150N·m 가정과 2040 프레임 배치를 다시 계산한다.
- 정적 전도 여유를 대략 계산하면 지지다각형의 최소 거리는 약 193mm이고, 55kg에서 저항 모멘트는 약 104N·m다. 암 전개와 주행 가감속을 함께 고려하면 여유가 작으므로 암 선정 후 상세 검토가 필요하다.
- 2020/2040 단면 2차 모멘트(0.70/약 4.5cm⁴)는 카탈로그 확인값이 아니다. MISUMI HFS5 계열 수치로 확인해야 한다.
- 이 FEM은 판 굽힘 스크리닝이다. 볼트 체결부, 프로파일 연결부 강성, 피로, 충격은 포함하지 않았다.

## 5. 결정: 판 두께 3t (Rev09a)

- 상판·하판을 강판 3t로 바꿨다(`layout.json`). 하판 윗면 Z120과 상판 밑면 Z283을 유지해 요크·기둥·센서 기준면은 그대로 두고, 하판 밑면은 Z116에서 Z117로, 상판 윗면은 Z287에서 Z286으로 바뀌었다. 판 2장의 강재 질량은 13.1kg에서 약 9.8kg이 됐다.
- 같은 하중 조건에서 3t 계산 결과는 아래와 같다. **프로파일 프레임이나 레일 없이 3t만 쓰는 것은 승인할 수 없다.**

| 판 | 3t 판만 | 3t + 프레임·레일 |
|---|---|---|
| 상판 (전도 모멘트 150N·m) | 163MPa, 기울기 0.49°, 처짐 1.13mm | 2020 앞뒤 + 2040 좌우·크로스: 35MPa, 0.11°, 0.22mm |
| 하판 (2g) | 156MPa, 처짐 5.0mm | 2020 종방향 레일 2개: 31MPa, 0.51mm |

## 6. 후진·단차·경사 진입 검토

흔들팔에 지면 힘이 작용할 때 피벗 둘레 모멘트는 다음과 같다(휠 축 기준, 단차 반력은 모서리에서 휠 중심을 향한다).

- **단차 반력:** 반력이 휠 축을 지나므로 피벗이 축 높이에 있으면 수평 성분은 모멘트를 만들지 않는다. 이때는 전후진이 대칭이다. 피벗이 축보다 높이 h_p만큼 위에 있으면 피벗이 바퀴를 따라오는(leading) 쪽에서 수평 성분이 들림을 방해한다.
- **견인력 들림(jacking):** 지면 견인력 Fx는 피벗 높이 H만큼 아래에서 작용한다. 따라서 접지하중이 ΔFz = Fx·H/L만큼 변한다. 트레일링 방향 주행에서는 하중이 늘고, 반대 방향 주행에서는 줄어든다.

### 캐스터 로커 (현재 Rev09)
- 4개 모두 피벗이 캐스터 안쪽 100mm, 캐스터 축 위 56mm에 있다. 그래서 **전진할 때는 전방 캐스터, 후진할 때는 후방 캐스터가 leading arm**이 된다. 차체가 앞뒤 대칭이므로 후진이 전진보다 특별히 불리하지는 않다. 다만 진행 방향 앞쪽 캐스터는 어느 방향이든 불리하다.
- Ø64 캐스터가 10mm 단차에 닿을 때 들림 모멘트를 비교했다(단위 힘당). 앞쪽 캐스터(바퀴가 끌려 레버 78mm)는 78×0.687−56×0.727 ≈ 13이고, 뒤쪽(레버 122mm)은 ≈ 125로 **약 1/10**이다. 단차가 약 13mm(접촉각 54°)를 넘으면 모멘트 부호가 바뀌어 로커가 오히려 눌린다. 즉 앞쪽 로커는 단차에서 거의 강체처럼 충격을 전달한다.
- GL-65(Ø64) 자체의 단차 극복 한계도 약 10mm 수준이다. 따라서 **운용 조건을 단차 10mm 이하, 경사 진입부 둔각 처리**로 정하고 시제품으로 확인한다. 피벗을 축 높이에 가깝게 내리면 개선되지만, 캐스터 높이 83mm와 하판 Z117 제약 때문에 구조 변경이 필요하다.

### 구동륜 (현재 수직 가이드 vs 3절 제안 A의 스윙암)
- **현재 수직 가이드는 방향에 중립이다.** 견인력이 가이드에 수평으로 걸리므로 들림이 없고, 단차 반응도 전후진이 같다. 이것은 제안 A가 잃는 장점이다.
- 스윙암(피벗 Z90, 축 높이)으로 바꾸면 10mm 단차에서 Ø180 휠에 필요한 견인력은 접지하중의 약 0.52배다. 공칭 150N이면 약 77N이다. 이로 인한 하중 변동은 L=150mm에서 ±46N(31%), L=250mm에서 ±28N(19%)이다. **후진으로 단차를 넘을 때 구동륜 하중이 150N에서 104N(L=150)까지 줄어** 미끄럼 위험이 커진다. 5° 경사 진입은 약 ±14N(L=150)으로 영향이 작다.
- 결론: 후진 운용(도킹 등)이 잦다면 **구동륜은 수직 가이드를 유지**하고, 끼임 위험(휠 X 오프셋 53mm)은 가이드 간격·부시 길이·볼부시 적용 검토로 줄이는 것이 낫다. 스윙암을 쓰려면 L≥250mm, 피벗을 축 높이에 두고, 후진 단차 통과는 저속으로 제한한다.
