hsh3167/amr_project/docs/engineering-decisions.md

# AMR 설계 판단 — Rev05 (2026-11-10)

## 도면 반영 범위

[모터 스펙시트 판독](motor-datasheet-review.md)을 치수/사양의 근거로 사용합니다. 기존 임의44mm 폭과 Ø16×45 축을 교체했습니다. 실제 단축의 치수 및 길이연쇄를 반영했고 케이스Ø140/타이어 내경, 단순 포크, 브라켓은 명시적으로 가정입니다. 커버6개 나사의 위치를 장착 PCD로 추정하지 않습니다. M14너트20Nm/243 도포 주기를 체결계획에 반영하되 실제 와셔·너트·돌출 길이·유효 체결산 수를 확인합니다.

## 캐스터 접지와 구동륜 반력

좌표계는 X우측/Y전방/Z상방, 지면Z0. 모터 타이어 중심Z90, 캐스터 축Z32입니다. Rev06은 공식 GL-65-ASF-EUS STEP의 장착면Z83을 유지하며 카탈로그82와 구분합니다. 하판 밑면Z116으로 공칭 차이는33mm입니다. 기존 강체 스페이서를 제거하고 가동 캐리어Z83~87, 스프링 공간Z87~112, 고정 상부좌대Z112~116으로 대체했습니다. 캐스터 장착홀은 조립 좌표에서24X×54Y입니다. 실제 보유품 높이·고무 압축·EUS/TUN을 확인해야 합니다.

Ø180±2 타이어 편차만으로 구동륜 중심 높이가±1mm이고 압축/캐스터/판 평면도 편차가 더해집니다. 6개 휠을 모두 강체로 같은 지면에 놓는 방식은 하중을 균등하게 만들지 않습니다. 불균일 바닥에서 중앙 구동륜이 뜨거나 캐스터가 과하중될 수 있으므로 구동륜2개와 캐스터4개에 각각 독립 스프링 지지 구조를 적용했습니다. 스프링 예압과 바퀴별 하중을 시험으로 맞춰야 합니다. 임의로1~2mm 낮추는 값은 시험 없이 확정하지 않습니다.

정적 총중량W와 각 접점의 정상반력 Ni에 대해 ΣNi=W와 모멘트 평형을 만족하면서 구동륜에 필요한 Ni를 확보해야 합니다. 가용 견인력은 μ×(구동륜 두 개 반력 합)과 모터 토크 한계 중 작은 쪽입니다. μ는 바닥/타이어별 실험값이 필요합니다. 4Nm/0.09m=약44.4N/륜, 합88.9N은 모터 정격토크에서의 이상적인 환산이며 적재량을 의미하지 않습니다. 스톨은 연속 운용점이 아닙니다.

캐스터 회전 중심±138/±215에서 휠이22mm 옵셋으로 선회합니다. 바퀴 자체 스위프 반경은22+sqrt(32²+11.5²)≈56.0mm이며 포크/헤드 여유가 더 필요합니다. 현재 직진자세 STEP 경계606.5mm를 최대 선회/배선 엔벨로프로 쓰지 않습니다. 전후 휠 스위프, 전장/배선/프레임 간격과 턱 통과를 실제 CAD에서 확인합니다.

## 전원과7S9P

보유팩 재사용은 화학종/정격/BMS/상태/충전기/치수 확인 후 결정합니다. 일반 Li-ion7S는25.2V공칭(3.6V/셀 가정)/29.4V완충이며 모터18~30V와 공칭으로 겹칩니다. 그러나 완충에서0.6V 여유만으로 회생/과도전압 적합성을 보증할 수 없습니다. **모터 입력범위와 드라이버 DC버스 한계는 별도**입니다. 드라이버의 정상/절대최대전압, 저전압차단, 전류 제한, 회생저항/제동초퍼 또는 클램프, BMS의 회생충전 허용과 만충 차단을 확인합니다. 일반 TVS만으로 지속 회생 에너지를 처리한다고 가정하지 않습니다.

LiDAR9~28V에는 안정화24V계통을 사용하고, 카메라5V/USB 및 제어기 전원도 분리합니다. DC/DC는29.4V와 검증된 과도전압을 견디고 저전압 영역에서도 필요한24V를 유지하는 방식으로 선정합니다. 모터 정격10A/스톨30A는 드라이버 전류 정의(상 RMS/피크/DC버스)를 대조해야 하므로 BMS 용량을 단순20A/60A로 확정하지 않습니다. DC퓨즈/접촉기/비상정지와 제어전원 유지/회생 경로를 전장 설계에서 결정합니다.

## 센서와 상판

TiM571 두 개를 전방 좌측/후방 우측 코너에 대각 배치하고 약241mm 동일 스캔면을 사용합니다. 사각90°는 차체 안쪽으로 향하게 합니다. [Rev05 배치 근거](layout-rev05.md)의 기하 표본 검사는 실제360° 감지를 보증하지 않습니다. 안전등급 스캐너로 사용하지 않습니다. 카메라는 MX6000 제품군 외형과2×M2만 확인되며 특정 A V1.2 PCB의 실제 홀/배선 확인이 필요합니다. 구조광2대의 상호간섭 및 USB 대역폭을 시험합니다. 좌우±15°/하향10°는 배치 가정입니다. 카메라 지지대를 상판에서 아래로 매달아 LiDAR 스캔면을 관통하지 않도록 했습니다.

향후 로봇암 설치는 현재4mm 상판/155mm 보강 더미/임의124mm 패턴으로 승인하지 않습니다. 최대 작동반경에서 무게중심/지지다각형/전도 모멘트, 상판 휨, 프로파일 접합 강성, 정지·가속 하중을 다시 계산합니다. 차량 목표 총중량·적재량·목표속도·턱 높이가 아직 필요합니다.

## CAD 운영

build123d 코드/JSON/STEP을 변경 추적하고, 세부 제작도면 및 실제 체결 조립 검증은 FreeCAD 등에서 수행합니다. 웹 애니메이션은 회전 방향과 배치 이해를 위한 데모이며 동역학/SLAM/강도 검증이 아닙니다. 생성 파일 검사 결과와 공개 페이지의 실제 배포 버전을 구분하여 확인합니다.

## 수직 기둥 및 배치 데이터

주기둥4개/센서 기둥4개/서스펜션 기둥4개 모두 알루미늄 프로파일을 사용합니다. 공칭20×20, 슬롯6/내부폭10, 중앙보어4.2는 구매업체 단면 미확정 상태의 일반화한 형상입니다. 알루미늄 합금/제품 단면관성/접합강성은 확인 전입니다. 상판 주기둥 체결 구멍은 M5 가정의Ø5.5로 조정했고 미래 로봇암의Ø8.4 가정 구멍과 구분합니다. 장비 제작용 확정 강도계산은 아닙니다.

CAD는 build123d0.12.0 Python으로 생성하고 웹은 동일 BRep에서 내보낸 GLB를 Three.js로 표시합니다. 기존 CadQuery2.5.2 환경은 Rev05 회귀 검증용으로 분리 보존합니다. FreeCAD는 STEP 검토 사본을 만들며 Python 코드에 수정이 역반영되지 않습니다. 공통 배치는 `cad/layout.json`, 구매품 사양은 `cad/parts.json`에서 관리합니다.

## Rev06 독립 서스펜션

구동륜 좌우 각각 가이드2개+가동 축 클램프/캐리어+코일스프링+상부좌대를 적용했습니다. 각 캐스터도 가동 장착판+가이드2개+스프링으로 독립 지지합니다. 구동륜 스트로크20mm(±10), 캐스터10mm(±5)는 설계 가정입니다. 스프링 외경/선경/권수도 개념 형상이며 강성·예압·감쇠·피로 수명을 보증하지 않습니다. 가이드 마찰/부싱/와이퍼/끝단 고정·축 토크반력·체결은 상세 설계가 필요합니다. 스프링만 있는 구조이며 실제 댐퍼는 선정·모델링하지 않았습니다.

구동 스프링 공칭 길이57mm, 범프47/드룹67mm. 캐스터는25mm, 범프20/드룹30mm입니다. 서스펜션 프레임 때문에 드라이버 공간을Y85에서Y125로 옮겼고, 기존 캐스터 스페이서와Y±215 횡부재를 제거했습니다. 새 지지부는 기존 하판에 접촉하도록 배치했으나 실제 체결홀/볼트/강도는 미완성입니다. 여섯 스프링의 예압을 잘못 맞추면 중앙 구동륜이 언로드될 수 있으므로 총중량/적재량을 확정하고 바퀴별 정하중과 구동 견인력을 측정합니다. 30개 선별 스트로크 자세의 기하 간섭 검사는 동역학·연속 스위프·타이어 압축 검증을 대체하지 않습니다.
