hsh3167/amr_project/docs/motor-datasheet-review.md

# ZLLG65ASM250-N V2.02 스펙시트 판독 — Rev04

2026-11-09 22:37:18 KST Gmail 첨부 `ZLLG65ASM250-N V2.02 Spec Sheet-20240312 (1).pdf`, 총 23쪽. 표지 날짜 2024-03-12, 문서 V1.00, 제품 V2.02. PDF SHA256: `c41f7ad802673a0d04b1be5f2274cf598d584c5799af4351783f2bc129d9f72f`.
첨부 원본은 로컬 `tmp/pdfs/motor.pdf`에 보관하며 공개 저장소에는 재배포하지 않습니다. 페이지 번호는 PDF의 1부터 세는 번호입니다. p.7 외형도와 p.8 타이어/너트, p.9 배선도를 확대하여 확인했습니다. 이전 -4096 모델의 치수를 가져오지 않았습니다.

## 외형 및 체결 치수 (mm)

| 항목 | 도면 값 | 반영 |
|---|---|---|
| 타이어 외경 | Ø180 ±2 | 무부하 공칭 반경90; Rev03 사용자 Ø180과 일치 |
| 타이어 폭 | 42.5 ±1 | 기존 가정44를 교체; p.8도42.50 |
| 외측 케이스면~축 끝 | 89.8 ±1 | 케이블/커넥터 제외한 축방향 범위 |
| 외측 케이스면~타이어 외측면 | 9.85 | 별도 공차 미표기 |
| 내측 케이스면~축 끝 | 25.6 ±0.5 | 축 돌출 길이 |
| 나사 길이 | 23.5 ±0.3 | M14×1.5; 실제 나사산은 단순 축으로 표시 |
| 케이스면~나사 시작 단차 | 2.1 ±0.2 | 25.6-23.5와 일치 |
| 축 지름 | Ø14, 상한편차 -0.1 / 하한편차 -0.4 | 허용13.6~13.9, CAD는 공칭14 엔벨로프 |
| 축 양 평면 간격 | 10 ±0.1 | 회전방지 평면; 브라켓 슬롯10.2는 별도 설계 가정 |
| 케이블 길이 | 320 | 배선 굴곡/출구 슬리브와 커넥터 크기는 미확정 |
| 타이어 재료/경도 | NBR, Black, Shore A45~55 | p.7; p.8 재료 주기와 차이 아래 참조 |
| 브레이크 | No brake | p.7, V2.02 변경 이력 p.2 |
| 너트 조립 | 20N·m, 243 나사고정제 | p.8, 너트는 미장착 상태로 동봉(p.2) |

좌표 u는 타이어 중앙0에서 차체 안쪽이 양수입니다. 공칭 연쇄계산으로 외측면 -31.1, 내측 케이스면 +33.1, 나사 시작 +35.2, 축 끝 +58.7입니다. 케이스 축방향 길이64.2는 이 값에서 **계산한 값**이며 독립 공차가 아닙니다. 각 치수 공차를 독립 최악조건으로 합산할지 여부는 제조사 기준면/공차 연쇄를 확인해야 합니다.

케이스 지름, 타이어 내경, 케이스 곡면, 6개 커버 나사의 PCD/나사, 축 케이블 관통구, 너트/와셔/커넥터 치수는 **도면 치수 없음**. CAD의 케이스 Ø140 및 동일 타이어 내경은 외관을 단순화하기 위한 명시적 가정입니다. 커버 나사를 차체 마운트 홀로 간주하지 않습니다. 고정축의 평면에 토크반력을 전달하고 너트로 축방향 고정하는 브라켓을 설계해야 합니다. 브라켓 6t/슬롯10.2와 체결 스택은 제작 승인 전 검증 대상입니다. 축 표면 JARMET 처리 주기가 있습니다.

## 전기 성능 — 본문 p.3~4를 설계 기준으로 적용

| 항목 | 값 |
|---|---|
| 정격 / 사용전압 | 24V / 18~30V |
| 정격 토크 / 속도 / 전류 | 4N·m / 500rpm / 10A |
| 스톨 토크 / 전류 | 11.7N·m / 30A, 토크 표기1min |
| 무부하 속도 / 전류 | 600rpm / ≤1.5A |
| 엔코더 | 1024±1라인, 자석식, 단일종단 A/B |
| 엔코더 전원 | 4.5~5.5V, 대표5V |
| 구성 | 3상, 30극, 단축 |

4Nm×500rpm의 기계출력은 약209W입니다. 도면의250W 표기를 본문 동작점과 같은 출력이라고 단정하지 않습니다. 1024라인의 A/B 4체배는 드라이버가 지원할 때4096count/rev로 **계산**되며 4096라인 엔코더가 아닙니다. Ø180에서 이론 직진 환산은 0.138mm/count이지만 미끄럼/처짐/유효반경 오차는 별도입니다. 500rpm 환산속도4.71m/s는 모터 정격점일 뿐 학생 실험용 AMR 목표속도가 아닙니다. 초기 속도 제한 예0.3m/s(약31.8rpm)는 제어 설계 가정입니다.

## 문서 내부 충돌 및 판독 한계

| 위치 | 충돌 | 처리 |
|---|---|---|
| 본문 p.3~4 vs p.7 표 | 사용18~30V/정격24V vs Rated Voltage24~48VDC | 48V 운용 승인으로 해석하지 않음; 본문18~30V 유지, 제조사 확인 필요 |
| p.4 vs p.7 표 | 스톨11.7Nm vs Maximum12Nm | 11.7Nm 적용, 12Nm를 연속토크로 쓰지 않음 |
| p.4 vs p.7 표 | 무부하600rpm vs Maximum560rpm | 서로 다른 항목/조건일 수 있음; 최대 운용속도 확정 보류 |
| p.5 vs p.7 표 | 질량3.15±5%kg REF vs3.25kg | 질량/하중 계산 전 실측 |
| p.7 vs p.8 타이어도 | NBR45~55A vs Shore30A specific grade TBD 문구 | p.7 표시를 기준으로 기록하되 납품품 경도/재질 확인 |
| p.7 vs p.9 배선표 | p.7 핀4/5 thermistorA/B vs p.9 핀4/5 N/C | V2.02 p.2는 thermistor 표기 추가. p.9의 과거 배선표를 그대로 배선하지 말고 납품품/제조사 확인 |
| p.6 수명시험 | 240000cycles TBD / no test completed | 신뢰성 인증 완료로 주장하지 않음; p.11~23은 V2.0의 과거 시험 부록 |

## 다른 지정 부품 확인

수량은 모터2, SICK TiM571-2050101 2, Orbbec Astra Mini Pro MX6000 A V1.2 2, GL-65-ASF 4로 유지합니다.

- [SICK 공식 PDF](https://www.sick.com/media/pdf/4/44/444/dataSheet_TiM571-2050101_1075091_ko.pdf): 외형도 p.5의76.25/74.39/101.12, 270°, 9~28V. M3 막힌 나사 깊이2.8mm/최대0.8Nm. 단순 모델은 커넥터 여유와 광학면 위치를 보증하지 않습니다. 이 센서는 안전용 스캐너가 아닙니다.
- [Orbbec 공식 제품자료](https://store.orbbec.com/products/astra-mini-pro): MX6000, W84.90×H20.00×D19.92, 깊이 FoV H58.4°×V45.5°, 5V≥0.5A, USB2.0 DF13, 2×M2. 특정 A V1.2 PCB의 홀 피치는 공개 페이지로 확인되지 않았습니다. 전방 두 카메라의 구조광 상호간섭/USB 대역폭을 실험해야 합니다.
- [지덕산업 GL-65 EUS 공식자료](https://www.gdok.co.kr/sub/caster_detail.php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): ASF 회전형 Ø64×폭23, 설치82, 옵셋22, SF 플레이트65×48(RF65×38과 구별), 홀54×24/Ø7, 50kg/개. 보유품 EUS/TUN suffix 및 실측은 미확정입니다. 4×50kg를 로봇 허용 적재량으로 바로 쓰지 않습니다.
