hsh3167/amr_project/bom/concept_bom.csv

Category | Item | Qty | Unit | Supply | Specification | Status | Cost_KRW | Notes
Mechanical | ZLLG65ASM250-N V2.02 NBR wheel motor | 2 | ea | Company reuse | OD180+-2 / W42.5+-1 / axial89.8+-1 / 24V 18-30V / 4Nm 500rpm 10A / stall11.7Nm 30A / encoder1024 | Datasheet-guided | 0 | PDF pp3-8; shaft D14 AF10 M14x1.5 thread23.5; casing OD140 assumed; conflicts documented
Mechanical | GL-65-ASF swivel caster | 4 | ea | Company reuse | OD64 / catalogue H82 / official CAD H83 / offset22 / plate48X65Y / holes24X54Y | Manufacturer EUS STEP reference | 0 | Confirm actual EUS/TUN; CAD wheel/hub width30.4 vs tread23; independent spring stage each
Mechanical | Lower steel plate | 1 | ea | Laser cut | 390x530x3 steel at Z117-120; wheel wells inner X+-175; suspension holes | Concept (Rev12b) | TBD | Strength without profile stiffening insufficient (docs/plate-suspension-review.md)
Mechanical | Upper steel plate | 1 | ea | Laser cut | 420x550x3 steel at Z283-286 | Concept (Rev12b) | TBD | Reserved for optional robot arm; 2040 frame pending
Mechanical | 2020 aluminum extrusion | 8 | ea | Buy or scrap | 163mm x4 main + LiDAR supports x2 + camera hangers 28mm x2; generic 20x20 | Material confirmed; section assumed | TBD | Brand/section/end taps/stiffness pending; 4t collar plates at column feet and deck
Mechanical | Sensor brackets | 4 | set | Make | LiDAR: 3t bent bracket (2 bends) wrapping two faces of the main column, 4x M5x10 + 2020 T-nut; camera: 90x74x3 plate under a 28mm hanger + 3D-printed 10 deg wedge | Rev14 modelled (estimate) | 50000 | Estimate: LiDAR bracket 15,000 x2 + M5/T-nut 500 x8 + camera plate 5,000 x2 + wedge print 3,000 x2; SICK M3 and camera M2 screws not drawn
Mechanical | Motor mount | 2 | set | See suspension BOM | Axle AF10 in the drive swing arm end wall slot AF10.2; washer + 4.9 trial spacer + M14x1.5 nut | Rev12 modelled | 0 | Priced in suspension_misumi.csv (drive arm, axle spacer set); torque reaction strength not verified
Mechanical | Caster mounting | 4 | set | See suspension BOM | GL-65 2mm plate (measured from OEM STEP) clamped under the 6t caster arm: CB6-16 head under the plate + M6 nut on the arm | Rev13 modelled | 0 | Priced in suspension_misumi.csv (CB6-16, M6 nuts)
Mechanical | Structure fasteners | 1 | set | MISUMI + local hardware | CB5-12 x12 into the M5-tapped 2020 cores (4 main, 2 camera-hanger columns, both ends) 262 KRW each (MISUMI 2026-11-14); M8x16 + nut x4 clamp the deck arm reinforcement (placeholder for the arm bolts) | Rev13 modelled | 5144 | CB5-12 12x262 = 3,144 MISUMI price + M8 set estimate 2,000; Rev14
Electrical | Electronics supports | 1 | set | Buy | M4 hex standoffs x20 (motor drivers 14mm, controller PCB 22.5mm, computer 10mm on the PCB, power bay 9mm) + 4 rubber pads 15mm under the battery; battery strap TBD | Rev13 modelled (estimate) | 8000 | Estimate: standoff 300 x20 + pad 500 x4; envelopes are reservations until hardware is chosen
Electrical | SICK TiM571-2050101 LiDAR | 2 | ea | Company reuse | 270-degree /9-28V /front-left +rear-right diagonal /scan plane approx241mm | Specified | 0 | Blind90 inward; optical origin and housing clearance need confirmation
Electrical | Orbbec Astra Mini Pro MX6000 A V1.2 | 2 | ea | Company reuse | 84.9x20x19.92 / front left and right | Official family STEP V0.1 reference | 0 | 58 solids each; 3D depth24.264 vs drawingV1.2 depth19.92; M2 pitch80; exact hardware/adapter pending
Electrical | Battery pack | 1 | ea | Company reuse if approved | 7S9P pack chemistry and BMS unknown | Pending | 0 | Replace placeholder model with actual pack
Electrical | Motor driver | 2 | ea | Check existing stock | 3-phase servo; 5V single-ended1024-line AB/Hall; current and regen compatibility TBD | Pending | TBD | Motor18-30V is not driver bus rating; 7S full29.4V leaves0.6V to30V; thermistor pin4/5 conflict
Electrical | Computer/SBC | 1 | ea | Check existing stock | ROS2 capable | Pending | TBD | Front service bay Y180; model envelope pending
Electrical | Microcontroller | 1 | ea | Check existing stock | Wheel motor low-level bridge | Pending | TBD | Depends on driver interface
Electrical | DC-DC converter | 1 | set | Reuse or buy | Regulated24V for TiM571 + 5V USB/compute; input and transient range TBD | Pending | TBD | Rear service bay Y-200; regulated24V for TiM571 max28V; not direct29.4V pack
Electrical | Fuse DC power disconnect and E-stop | 1 | set | Buy rated parts | Properly rated DC circuit protection | Required | TBD | No battery connection before protections installed
Electrical | Wiring connectors and harness | 1 | set | Buy or reuse | Current-rated battery and motor wiring | Required | TBD | Strain relief/cable routing
Electrical | Compatible battery charger | 1 | ea | Company reuse if approved | Match exact cell chemistry and BMS | Required | TBD | Never use chemistry-mismatched charger
Software | ROS2/Linux | 1 | set | Open source | Nav2 SLAM Toolbox and teleop | Proposed | 0 | Depends on compute and drivers
Software | Interactive 3D viewer | 1 | set | Open source | Three.js GitHub Pages | Done | 0 | Illustrative not dynamic simulation
CAD | Parametric STEP generator | 1 | set | Open source | build123d Python source | Done | 0 | Common layout.json/parts.json with Rev05 CadQuery baseline preserved
Mechanical | Independent hinge + spring suspension modules | 6 | set | MISUMI plus fabricated sheet metal | Rev14: 3t bent arms/brackets (bend limit 3t), 8t flat bosses, CLBKHM10 pins, MPFZ10-10 bushes, X-SWU springs, C-USLH10 stoppers; 55kg design mass | Prototype validation pending | 528584 | See suspension_misumi.csv: MISUMI price 219,924 + estimate 308,660 KRW ex VAT (2026-11-14)
