hsh3167/amr_project/bom/suspension_misumi.csv

Module | Manufacturer | Order code | Quantity | Dimensions or role | Source | Status | Unit price KRW ex VAT | Order qty | Line total KRW ex VAT | Lead time | Price checked | Price basis
Drive | MISUMI | CLBKHM10-78.5 | 2 | D10 g6 hardened hinge pin head16 M6 tap; fixed in bracket ears (Rev12a asymmetric arm) | https://kr.misumi-ec.com/pdf/fa/2018/p1_065_2021_202108.pdf | Catalog p1_065 checked 2026-11-12; MISUMI STEP 2026-11-14 placed in the assembly (Rev12b); matches model (D10 L78.5 head16x1.5) | 10920 | 2 | 21840 | ref ship 2026-11-24 | 2026-11-14 kr.misumi-ec.com | MISUMI price
Caster | MISUMI | CLBKHM10-75 | 4 | D10 g6 hardened hinge pin head16 M6 tap; fixed in bracket ears | https://kr.misumi-ec.com/pdf/fa/2018/p1_065_2021_202108.pdf | Catalog p1_065 checked 2026-11-12; MISUMI STEP 2026-11-14 placed in the assembly (Rev12b); matches model (D10 L75 head16x1.5) | 10920 | 4 | 43680 | ref ship 2026-11-24 | 2026-11-14 kr.misumi-ec.com | MISUMI price
Drive and caster | MISUMI | MPFZ10-10 | 12 | Flanged oil-free bush ID10 F7 OD14 m6 L10 flange22x2; two per arm pressed into 14 H7 | https://in.misumi-ec.com/pdf/fa/2014/p1_383.pdf | Catalog p1_383 checked 2026-11-12; MISUMI STEP 2026-11-14 placed in the assembly (Rev12b); matches model (OD14 L10 flange22x2; bore nominal 10.0; F7 after press-fit) | 5874 | 12 | 70488 | stock; ref ship 2026-11-17 | 2026-11-14 kr.misumi-ec.com | MISUMI price
Drive and caster | MISUMI | C-USLH10 | 6 | Economy urethane stopper, male thread: D10 L17 M5x0.8 thread 7, Shore A90 polyurethane on stainless core; screwed into the arm (M5 tap) = bump stop | https://kr.misumi-ec.com/vona2/detail/110310462869/ | MISUMI STEP (user-supplied 2026-11-14) placed in the assembly; stock 959 shown | 3161 | 6 | 18966 | ref ship 2026-11-17 | 2026-11-14 kr.misumi-ec.com | MISUMI price
Drive and caster | MISUMI | CB6-8 | 6 | Pin retention screw + M6 washer OD16 t1 | https://kr.misumi-ec.com/vona2/detail/110100141750/ | Retainer into the pin M6 tap (STEP depth ~18.6); verify torque | 325 | 6 | 1950 | ref ship 2026-11-17 | 2026-11-14 kr.misumi-ec.com | MISUMI price
Drive | MISUMI | X-SWU21-70 | 2 | OD21 ID13.5 L70 k5.39 N/mm solid21 F(55%L)38.5; installed 40 (gap45 + shim5) | https://kr.misumi-ec.com/pdf/mold/2016_CK/CK68.pdf | Catalog CK68 checked 2026-11-12; MISUMI STEP 2026-11-14 matches OD/ID/L; load +-10%; min order 10 | 3834 | 10 | 38340 | ref ship 2026-11-23 | 2026-11-14 kr.misumi-ec.com | MISUMI price
Caster | MISUMI | X-SWU17-35 | 4 | OD17 ID10.5 L35 k6.96 N/mm solid10.5 F(55%L)19.25; installed 23 (gap28 + shim5), 25mm inboard of the caster | https://kr.misumi-ec.com/pdf/mold/2016_CK/CK68.pdf | Catalog CK68 checked 2026-11-12; MISUMI STEP 2026-11-14 matches OD/ID/L; load +-10% | 2445 | 4 | 9780 | stock; same-day ship shown | 2026-11-14 kr.misumi-ec.com | MISUMI price
Drive and caster | Standard | M8 stud + 2 M8 nuts + washer OD16 | 6 | Tapped M8 in the 3t arm floor + threadlocker (droop load < 100 N); top nut on base = droop stop |  | Drive ~70 caster ~51 long per CAD | 1000 | 6 | 6000 |  | standard part, local hardware price | Estimate (not quoted)
Drive and caster | Standard | M6 hex bolt + M6 jam nut | 6 | Striker through the base plate; tip meets the C-USLH10 urethane tip = bump stop |  | Drive ~27 under head (M6x30 cut or x25 + washers), caster ~12 (M6x12); set with jam nut | 400 | 6 | 2400 |  | standard part, local hardware price | Estimate (not quoted)
Drive and caster | Fabricate or washer | Preload shim 5mm | 6 | Remove when the robot arm is not mounted |  | Standard washers | 500 | 6 | 3000 |  | standard part, local hardware price | Estimate (not quoted)
Drive and caster | MISUMI | CB5-12 | 16 | Hinge brackets to base plate (drive 4 each / caster 2 each): base 3 + bracket 3 + nut 4, 2 mm past the nut | https://kr.misumi-ec.com/vona2/detail/110100141750/ | Rev14 length | 262 | 16 | 4192 | ref ship 2026-11-17 | 2026-11-14 kr.misumi-ec.com | MISUMI price
Drive and caster | MISUMI | CB4-10 | 24 | Boss screws: from outside the 3t wall into the M4-tapped 8t boss (2 per boss) | https://kr.misumi-ec.com/vona2/detail/110100141750/ | Rev14 | 266 | 24 | 6384 | stock; same-day ship shown | 2026-11-14 kr.misumi-ec.com | MISUMI price
Caster | MISUMI | CB6-12 | 16 | GL-65 caster plate (2mm; OEM STEP) to the 3t arm pad: head under the plate + M6 nut on the pad | https://kr.misumi-ec.com/vona2/detail/110100141750/ | Rev14 stack: plate 2 + floor 3 + nut 5 + 2 past the nut | 269 | 16 | 4304 | stock; same-day ship shown | 2026-11-14 kr.misumi-ec.com | MISUMI price
Drive and caster | Standard | M5 hex nut | 16 | Chassis joints |  | Envelope and quantity | 50 | 16 | 800 |  | standard part, local hardware price | Estimate (not quoted)
Caster | Standard | M6 hex nut | 16 | OEM caster plate joints |  | Envelope and quantity | 60 | 16 | 960 |  | standard part, local hardware price | Estimate (not quoted)
Drive | Motor supplier | M14x1.5 axle nut | 2 | Check included nut AF and actual thickness |  | Trial fit required | 0 | 2 | 0 |  | included with motor (assumed) | Estimate (not quoted)
Drive | Fabricate | Axle washer and 4.9mm trial spacer | 2 sets | Rev09 axle stack |  | Confirm stationary shoulder | 10000 | 2 | 20000 |  | standard part, local hardware price | Estimate (not quoted)
Drive | Fabricate | S355 3t swing arm (channel) | 2 | Laser cut floor + 2 full-length side walls + end wall (3 bends, bend limit 3t); Y-44..+22.5; AF10.2 slot; bush bore 14 H7 with 0.5x45 entry chamfers; M8 tapped seat; M5 stopper hole |  | No welding | 30000 | 2 | 60000 |  | small-lot laser cut + 3 bends + tap per part; get quotes | Estimate (not quoted)
Caster | Fabricate | S355 3t swing arm (channel + pad) | 4 | Laser cut narrow floor + 2 side walls (2 bends) + flat 75mm pad over the GL-65 plate (holes 7mm from the edge); bush bore 14 H7; M8 tapped seat; M5 stopper hole |  | No welding | 22000 | 4 | 88000 |  | small-lot laser cut + 2 bends + tap per part; get quotes | Estimate (not quoted)
Drive | Fabricate | 3t U hinge bracket | 2 | Laser cut + 2 bends (3t); ear holes 10 H7 reamed together |  | No welding | 12000 | 2 | 24000 |  | small-lot laser cut + 2 bends per part; get quotes | Estimate (not quoted)
Caster | Fabricate | 3t U hinge bracket | 4 | Laser cut + 2 bends (3t); ear holes 10 H7 reamed together |  | No welding | 12000 | 4 | 48000 |  | small-lot laser cut + 2 bends per part; get quotes | Estimate (not quoted)
Drive and caster | Fabricate | S355 8t pivot boss (flat) | 12 | Flat laser-cut 8t, inside each side wall near the pivot: gives the MPFZ10-10 sleeve its 8 mm press length; bore 14 H7; 2x M4 tapped |  | Rev14; no bending | 4000 | 12 | 48000 |  | small-lot fabrication / local hardware; get quotes | Estimate (not quoted)
Drive | Fabricate | S355 3t axle torque plate (flat) | 2 | Flat 3t with AF10.2 slot inboard of the end wall; clamped by the axle nut; doubles the axle-flat bearing to 6 mm |  | Rev14; no bending | 3000 | 2 | 6000 |  | small-lot fabrication / local hardware; get quotes | Estimate (not quoted)
Caster | Standard | Seat spacer 3mm | 4 | Fixed 3mm washer/plate under the 5mm preload shim; keeps the Rev12 spring seat height on the 3t floor |  | Rev14 | 300 | 4 | 1200 |  | standard part, local hardware price | Estimate (not quoted)
Drive and caster | Standard | M5 hex nut (stopper) | 6 | Under the 3t floor on the C-USLH10 thread (3 + 4 = 7) |  | Rev14 | 50 | 6 | 300 |  | standard part, local hardware price | Estimate (not quoted)
Total |  | MISUMI priced items |  | Pins, bushes, springs, C-USLH10, CB screws; VAT 10% excluded |  |  |  |  | 219924 | 2026-11-14 |  | MISUMI price
Total |  | Estimated items |  | Standard hardware and fabricated sheet metal; rough estimate, get quotes |  |  |  |  | 308660 | 2026-11-14 |  | Estimate (not quoted)
Total |  | Suspension total (6 modules) |  | MISUMI price + estimate; VAT excluded; latest ref ship 2026-11-24 |  |  |  |  | 528584 | 2026-11-14 |  | Mixed
