hsh3167/amr_project/cad-output/amr_current.step

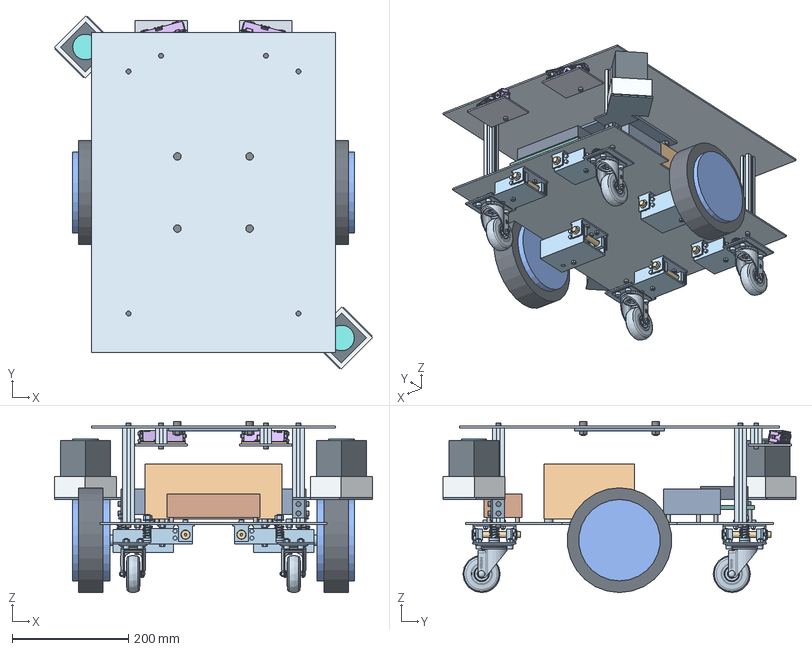
[picture p1: CAD file, 2026-11-14]
cad-output/amr_current.step
546.5 x 606.5 x 294.0 mm
01_lower_steel_plate_3t
20_upper_steel_plate_3t_PLACEHOLDER_HOLES
21_arm_reinforcement_PLACEHOLDER
10_2020_Al_column_LB
10_2020_Al_column_LF
10_2020_Al_column_RB
10_2020_Al_column_RF
30_NBR_OD180_W42p5_LEFT
31_casing_OD140_ASSUMED_axial_DATASHEET_LEFT
32_D14_AF10_M14x1p5_THREAD_BLANK_LEFT
30_NBR_OD180_W42p5_RIGHT
31_casing_OD140_ASSUMED_axial_DATASHEET_RIGHT
32_D14_AF10_M14x1p5_THREAD_BLANK_RIGHT
43_GL65_OEM_fork_RF x 4
41_GL65_OEM_plate_head_RF x 4
44_GL65_OEM_wheel_RF x 4
50_company_7S9P_BATTERY_DUMMY
51_controller_PCB_DUMMY
52_control_computer_DUMMY
54_REAR_power_distribution_DUMMY
53_motor_driver_DUMMY_-124
53_motor_driver_DUMMY_124
60_lidar_bracket_3t_FRONT_LEFT
61_SICK_TiM571_envelope_base_FRONT_LEFT
62_SICK_TiM571_optical_envelope_FRONT_LEFT
63_SICK_scanner_top_FRONT_LEFT
60_lidar_bracket_3t_REAR_RIGHT
61_SICK_TiM571_envelope_base_REAR_RIGHT
62_SICK_TiM571_optical_envelope_REAR_RIGHT
63_SICK_scanner_top_REAR_RIGHT
71_camera_adapter_CONCEPT_LEFT
71_camera_wedge_CONCEPT_LEFT
72_2020_Al_camera_column_LEFT
71_camera_adapter_CONCEPT_RIGHT
71_camera_wedge_CONCEPT_RIGHT
72_2020_Al_camera_column_RIGHT
80_drive_swing_arm_3t_LEFT
80_drive_axle_torque_plate_3t_LEFT
80_drive_axial_spacer_trial_LEFT
80_drive_axle_washer_LEFT
80_drive_axle_M14x1p5_nut_envelope_LEFT
80_drive_hinge_bracket_U_LEFT
80_drive_hinge_pin_RIGHT x 2
80_drive_pin_retainer_LEFT
80_drive_preload_shim_LEFT
80_drive_spring_coil_LEFT
80_drive_stud_M8_LEFT
80_drive_droop_stop_washer_nut_LEFT
80_drive_bump_stopper_nut_M5_LEFT
80_drive_bump_stop_bolt_M6_LEFT
80_drive_swing_arm_3t_RIGHT
80_drive_axle_torque_plate_3t_RIGHT
80_drive_axial_spacer_trial_RIGHT
80_drive_axle_washer_RIGHT
80_drive_axle_M14x1p5_nut_envelope_RIGHT
80_drive_hinge_bracket_U_RIGHT
80_drive_pin_retainer_RIGHT
80_drive_preload_shim_RIGHT
80_drive_spring_coil_RIGHT
80_drive_stud_M8_RIGHT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
