hsh3167/amr_project/cad/baseline/rev05/reference.step

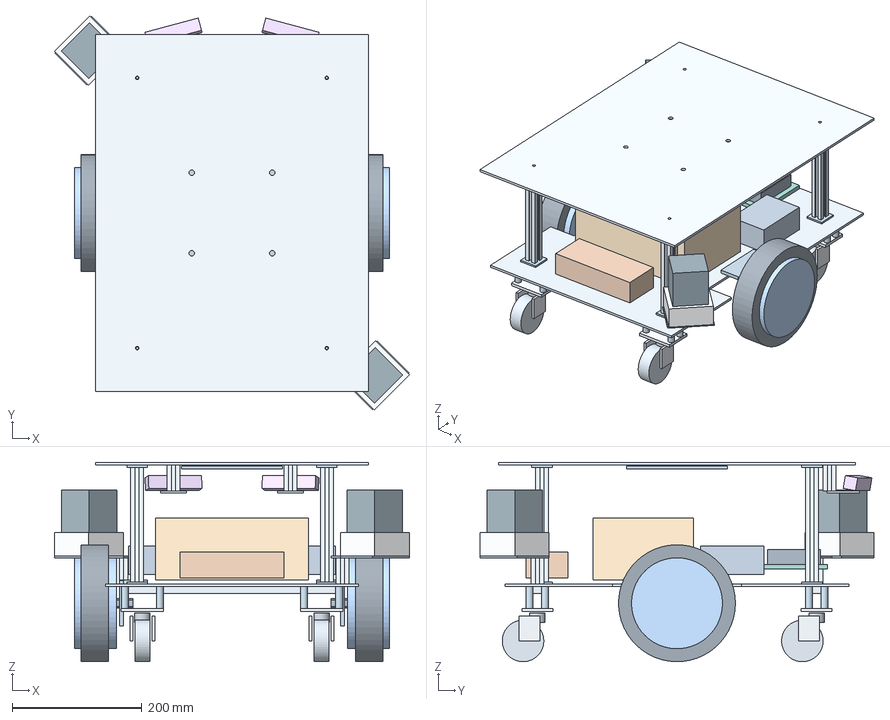
[picture p2: CAD file, 2026-11-10]
cad/baseline/rev05/reference.step
546.5 x 606.5 x 307.0 mm
01_lower_Al_plate_CONCEPT_part
02_axle_flat_bracket_CONCEPT_-1_part
03_bracket_bridge_CONCEPT_-1_part
02_axle_flat_bracket_CONCEPT_1_part
03_bracket_bridge_CONCEPT_1_part
04_base_crossmember_-215_part
04_base_crossmember_215_part
10_2020_Al_column_LB_part
11_corner_lower_LB_part
12_corner_upper_LB_part
10_2020_Al_column_LF_part
11_corner_lower_LF_part
12_corner_upper_LF_part
10_2020_Al_column_RB_part
11_corner_lower_RB_part
12_corner_upper_RB_part
10_2020_Al_column_RF_part
11_corner_lower_RF_part
12_corner_upper_RF_part
20_upper_Al_plate_PLACEHOLDER_HOLES_part
21_arm_reinforcement_PLACEHOLDER_part
30_NBR_OD180_W42p5_LEFT_part
31_casing_OD140_ASSUMED_axial_DATASHEET_LEFT_part
32_D14_AF10_M14x1p5_THREAD_BLANK_LEFT_part
30_NBR_OD180_W42p5_RIGHT_part
31_casing_OD140_ASSUMED_axial_DATASHEET_RIGHT_part
32_D14_AF10_M14x1p5_THREAD_BLANK_RIGHT_part
40_caster_spacer_CONCEPT_LB0_part
40_caster_spacer_CONCEPT_LB1_part
40_caster_spacer_CONCEPT_LB2_part
40_caster_spacer_CONCEPT_LB3_part
41_GL65_plate_65x48_HOLE54x24_LB_part
42_swivel_head_LB_part
43_fork_LB_-17_part
43_fork_LB_17_part
44_GL65_wheel_64OD_LB_part
40_caster_spacer_CONCEPT_LF0_part
40_caster_spacer_CONCEPT_LF1_part
40_caster_spacer_CONCEPT_LF2_part
40_caster_spacer_CONCEPT_LF3_part
41_GL65_plate_65x48_HOLE54x24_LF_part
42_swivel_head_LF_part
43_fork_LF_-17_part
43_fork_LF_17_part
44_GL65_wheel_64OD_LF_part
40_caster_spacer_CONCEPT_RB0_part
40_caster_spacer_CONCEPT_RB1_part
40_caster_spacer_CONCEPT_RB2_part
40_caster_spacer_CONCEPT_RB3_part
41_GL65_plate_65x48_HOLE54x24_RB_part
42_swivel_head_RB_part
43_fork_RB_-17_part
43_fork_RB_17_part
44_GL65_wheel_64OD_RB_part
40_caster_spacer_CONCEPT_RF0_part
40_caster_spacer_CONCEPT_RF1_part
40_caster_spacer_CONCEPT_RF2_part
40_caster_spacer_CONCEPT_RF3_part
41_GL65_plate_65x48_HOLE54x24_RF_part
42_swivel_head_RF_part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
