hsh3167/amr_project/cad-output/amr_6w_layout_rev03.step

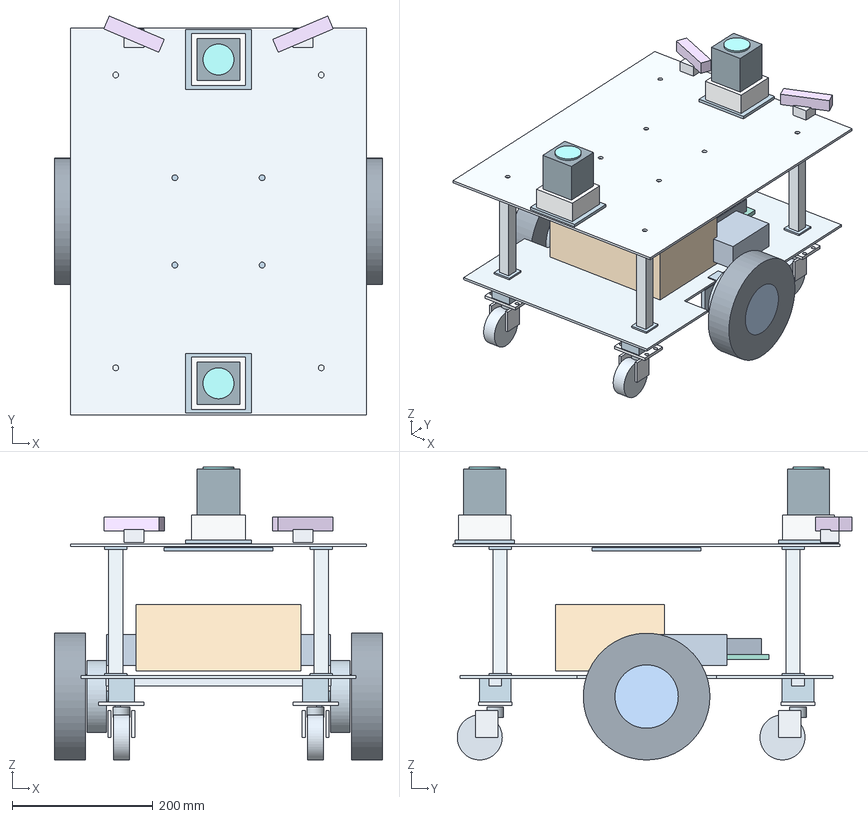
[picture p4: CAD file, 2026-11-09, an earlier design]
cad-output/amr_6w_layout_rev03.step
466.0 x 566.8 x 416.0 mm
01_lower_Al_plate_CONCEPT_part
02_wheel_bracket_upper_-1_part
03_wheel_bracket_vertical_-1_part
02_wheel_bracket_upper_1_part
03_wheel_bracket_vertical_1_part
04_base_crossmember_-215_part
04_base_crossmember_215_part
10_2020_extrusion_LB_part
11_corner_lower_LB_part
12_corner_upper_LB_part
10_2020_extrusion_LF_part
11_corner_lower_LF_part
12_corner_upper_LF_part
10_2020_extrusion_RB_part
11_corner_lower_RB_part
12_corner_upper_RB_part
10_2020_extrusion_RF_part
11_corner_lower_RF_part
12_corner_upper_RF_part
20_upper_Al_plate_PLACEHOLDER_HOLES_part
21_arm_reinforcement_PLACEHOLDER_part
30_180mm_rubber_tire_LEFT_part
31_motor_hub_PLACEHOLDER_LEFT_part
32_motor_body_SIMPLIFIED_LEFT_part
33_motor_shaft_UNKNOWN_LEFT_part
30_180mm_rubber_tire_RIGHT_part
31_motor_hub_PLACEHOLDER_RIGHT_part
32_motor_body_SIMPLIFIED_RIGHT_part
33_motor_shaft_UNKNOWN_RIGHT_part
40_caster_DROP_hanger_LB_part
41_GL65_plate_65x48_HOLE54x24_LB_part
42_swivel_head_LB_part
43_fork_LB_-17_part
43_fork_LB_17_part
44_GL65_wheel_64OD_LB_part
40_caster_DROP_hanger_LF_part
41_GL65_plate_65x48_HOLE54x24_LF_part
42_swivel_head_LF_part
43_fork_LF_-17_part
43_fork_LF_17_part
44_GL65_wheel_64OD_LF_part
40_caster_DROP_hanger_RB_part
41_GL65_plate_65x48_HOLE54x24_RB_part
42_swivel_head_RB_part
43_fork_RB_-17_part
43_fork_RB_17_part
44_GL65_wheel_64OD_RB_part
40_caster_DROP_hanger_RF_part
41_GL65_plate_65x48_HOLE54x24_RF_part
42_swivel_head_RF_part
43_fork_RF_-17_part
43_fork_RF_17_part
44_GL65_wheel_64OD_RF_part
50_company_7S9P_BATTERY_DUMMY_part
51_controller_PCB_DUMMY_part
52_control_computer_DUMMY_part
53_motor_driver_DUMMY_-124_part
53_motor_driver_DUMMY_124_part
60_lidar_mount_FRONT_part
61_SICK_TiM571_base_FRONT_part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
