hsh3167/amr_project/cad-output/amr_6w_layout_rev01.step

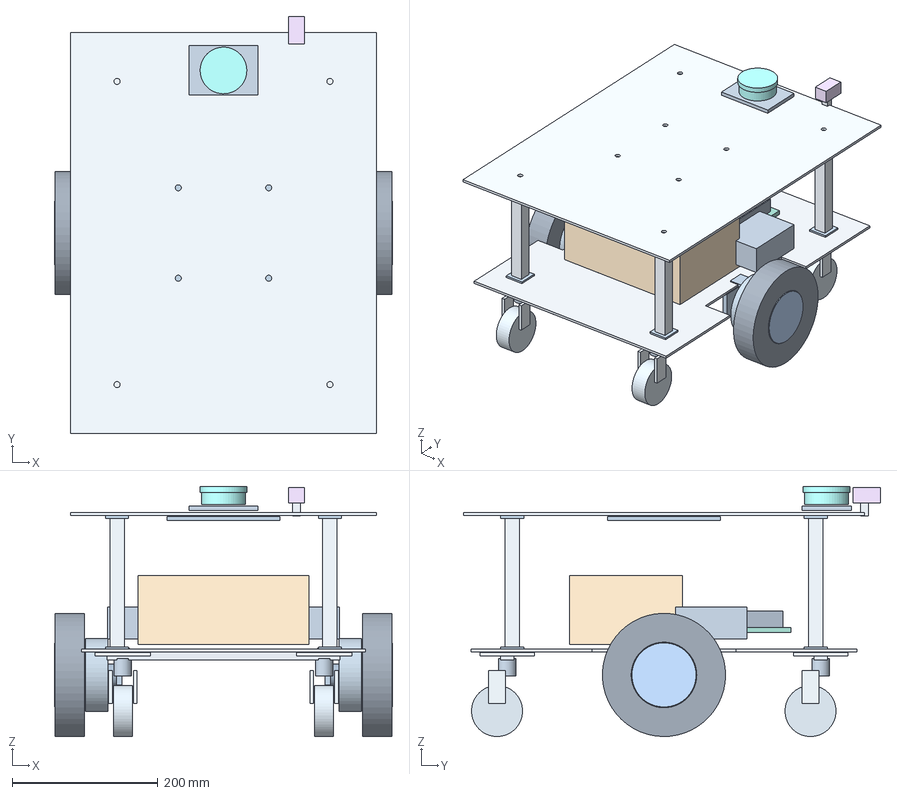
[picture p5: CAD file, 2026-11-04, an earlier design]
cad-output/amr_6w_layout_rev01.step
464.0 x 572.0 x 343.0 mm
01_bottom_plate_NOTCHED_part
02_motor_bracket_top_-1_part
03_motor_bracket_vertical_-1_part
02_motor_bracket_top_1_part
03_motor_bracket_vertical_1_part
04_base_cross_member_-215_part
04_base_cross_member_215_part
10_extrusion_LB_part
11_lower_corner_LB_part
12_upper_corner_LB_part
10_extrusion_LF_part
11_lower_corner_LF_part
12_upper_corner_LF_part
10_extrusion_RB_part
11_lower_corner_RB_part
12_upper_corner_RB_part
10_extrusion_RF_part
11_lower_corner_RF_part
12_upper_corner_RF_part
20_top_plate_8mm_HOLES_PLACEHOLDER_part
21_arm_reinforcement_PLACEHOLDER_part
30_tire_LEFT_part
31_hub_LEFT_part
32_motor_housing_ESTIMATED_LEFT_part
33_motor_mount_ESTIMATED_LEFT_part
30_tire_RIGHT_part
31_hub_RIGHT_part
32_motor_housing_ESTIMATED_RIGHT_part
33_motor_mount_ESTIMATED_RIGHT_part
40_caster_mount_LB_part
41_caster_swivel_LB_part
42_caster_fork_LB_-17_part
42_caster_fork_LB_17_part
43_caster_wheel_LB_part
40_caster_mount_LF_part
41_caster_swivel_LF_part
42_caster_fork_LF_-17_part
42_caster_fork_LF_17_part
43_caster_wheel_LF_part
40_caster_mount_RB_part
41_caster_swivel_RB_part
42_caster_fork_RB_-17_part
42_caster_fork_RB_17_part
43_caster_wheel_RB_part
40_caster_mount_RF_part
41_caster_swivel_RF_part
42_caster_fork_RF_-17_part
42_caster_fork_RF_17_part
43_caster_wheel_RF_part
50_BATTERY_7S9P_ENVELOPE_ONLY_part
51_controller_PCB_ENVELOPE_ONLY_part
52_controller_computer_ENVELOPE_ONLY_part
53_driver_ENVELOPE_-124_part
53_driver_ENVELOPE_124_part
60_lidar_bracket_ESTIMATED_part
61_lidar_dummy_part
62_lidar_top_part
70_front_camera_dummy_part
71_front_camera_bracket_part
