hsh3167/amr_project/(list of files, cad)

Other CAD files:
cad-output/amr_6w_layout_rev02.step
