hsh3167/amr_project/(commit log)

2026-11-04 feat: add parameterized CadQuery STEP assembly generator
2026-11-04 fix: pivot dual cameras around their mounting positions
2026-11-04 docs: record concept specs, battery alternatives and build instructions
2026-11-04 docs: add reuse-first concept BOM for student team
    [concept_bom.csv]
2026-11-04 ci: generate and commit STEP assembly on CAD changes
2026-11-04 build(cad): update parametric AMR STEP assembly
    [amr_6w_layout_rev01.step]
2026-11-04 docs: add CAD tool comparison and safe battery decision log
2026-11-09 feat(cad): Rev02 integrate exact model counts and verified envelopes
2026-11-09 ci: publish Rev02 STEP assembly
2026-11-09 fix(cad): switch to ZLLG65ASM250-N V2 rubber wheel Ø180 (rev03)
2026-11-09 ci: publish Rev03 STEP with Ø180 wheel motors
2026-11-09 docs: Rev03 corrected N V2 Ø180 BOM/geometry, dual sensors and clear assumptions
2026-11-09 docs(bom): specify 2 N V2 Ø180 motors, four GL65 casters, dual TiM571 and Astra Mini Pro
    [concept_bom.csv]
2026-11-09 feat: Rev04 datasheet-driven N V2.02 motor, shared dimensions and engineering review
    [concept_bom.csv]
2026-11-10 fix(viewer): stabilize sensor display and document Rev04 validation
2026-11-10 feat: Rev05 diagonal corner lidars, aluminum profile columns and service bay layout
    [concept_bom.csv]
2026-11-10 feat(cad): migrate Rev05 to modular build123d and add six independent spring stages
    [concept_bom.csv, reference.step]
2026-11-10 build(cad): generate verified build123d STEP and viewer meshes
    [amr_current.step]
2026-11-11 feat(viewer): display build123d assembly and individual wheel travel
2026-11-11 fix(cad): retain geometry in individual STEP exports
2026-11-12 feat(cad): design six MISUMI suspension modules for 30 kg
    [concept_bom.csv, suspension_misumi.csv]
2026-11-12 fix(cad): clear caster guide travel from diagonal LiDAR supports
2026-11-12 feat(viewer): show LiDAR and depth camera fields of view
2026-11-12 feat(viewer): display official SICK TiM5xx LiDAR mesh
2026-11-12 feat(cad): simplify caster guides and lower upper deck
    [suspension_misumi.csv]
2026-11-12 fix(viewer): revalidate CAD files after deployment
2026-11-12 feat(cad): use double-shear caster rocker suspension
    [suspension_misumi.csv]
2026-11-12 docs: plate thickness FEM screening and suspension simplification review
    Claude-Session: https://claude.ai/code/session_01RNSrRQYxtE4fSYShuvffJc
2026-11-12 feat(cad): use 3 mm steel deck and base plates; add reverse step review
    Base top Z120 and deck underside Z283 are kept as datums.
    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
2026-11-12 feat(cad): Rev10 suspension - drive side swing arms, fixed front casters, rear roll beam
    Replaces the Rev09 welded caster rockers and twin-shaft drive guides with
    laser-cut/bent parts: 6t swing arms pivoting on +Y pins (reused X-SWU17-70),
    4.5t box brackets for the front casters and one 6t roll beam with +-1 deg
    stops for the rear pair. Motion keys are now LEFT, RIGHT and REAR in the CLI,
    validation, tests and web viewer. Regenerated STEP/GLB/manifest.
    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
    [amr_current.step, suspension_misumi.csv]
2026-11-12 feat(cad): Rev11 six independent vertical rail suspension modules
    Every wheel now has its own MISUMI wide miniature rail (SSEBWML16 drive,
    SSEBWML14 caster), one X-SWU spring on an M8 guide bolt, a droop nut and a
    loose bump sleeve, on 1-bend 6t sheet brackets and carriers. Replaces the
    Rev10 swing arms, fixed front casters and rear seesaw, and avoids the Rev09
    plain-bush binding under motor torque. Pose keys return to LEFT/RIGHT/LF/LB/RF/RB.
    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
    [amr_current.step, suspension_misumi.csv]
2026-11-12 feat(cad): Rev12 six independent hinge + spring suspension
    Replaces the Rev11 rail modules with the simplest independent layout: per
    wheel one bent U bracket, one bent 6t arm, one MISUMI CLBKHM10 hinge pin
    (axis +Y), one X-SWU spring directly under the base plate on an M8 stud
    (top nut = droop stop) and an M6 bump-stop bolt. No rails, bearings,
    hangers or welding. Base wheel well widened to X+-175 for the drive spring.
    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
    [amr_current.step, suspension_misumi.csv]
2026-11-12 feat(cad): add MISUMI MPFZ10-10 flanged bushes to all six hinges
    Each swing arm now carries two flanged oil-free bushes pressed into 14 H7
    bores; the flanges act as thrust washers against the bracket ears. Ear gaps
    grow to 2.5 mm, the drive arm narrows to keep the pin within the catalog
    CLBKHM10 L100 limit (drive L100, caster L75), and the caster pivot drops to
    Z99.5 to leave 3.5 mm of web around the bore.
    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
    [amr_current.step, suspension_misumi.csv]
2026-11-13 feat(cad): Rev12a compact drive hinge arm
    - Drive arm: tray side walls replaced by short pivot tabs and a +-20 axle
    wall (still 3 bends); arm asymmetric Y-42.5..+21. 0.87 -> 0.48 kg each.
    - Drive bump stop moved to the spring line (X+-130, Y-25); bracket bolts
    at Y-25/+5; hinge pin CLBKHM10-100 -> CLBKHM10-78.5.
    - Drive module width 108.5 -> 87 mm, parts volume 158 -> 104 cm3;
    fabricated sheet total ~4.3 -> ~3.4 kg. Height and X length unchanged.
    - Asymmetric bracket/bush helpers, pin SKU/length check, bump stop
    placement checks, Rev12a regression test.
    - Unsprung drive estimate 3.6 -> 3.45 kg; docs/BOM updated with the
    rejected shorter-spring and shorter-arm options.
    Co-Authored-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
    [suspension_misumi.csv]
2026-11-13 chore(viewer): label layout revision 1.2a and describe Rev12a arm
    The Rev12a geometry was already in the generated GLB, but the viewer still
    showed REV 1.2 and Rev12 text. Bump the layout revision (also the GLB cache
    key) and the native-cad.js import version.
    Claude-Session: https://claude.ai/code/session_01RNSrRTLGj2bLCay6JXEWo3
2026-11-14 feat(cad): record MISUMI suspension CAD, prices and lead times
    - Add MISUMI STEP originals (gzip) for CLBKHM10-78.5/-75, MPFZ10-10,
    X-SWU21-70 and X-SWU17-35 with SHA256, size, source URL and notes in
    cad/vendor/provenance.json (existing entries kept).
    - Measured STEP dimensions match the model (pin D10, head 16x1.5,
    L78.5/75; bush OD14, flange 22x2, L10; spring OD/ID/L). STEP is a
    dimension reference only and is not placed in the assembly.
    - Caster spring max deflection 19.3 -> 19.25 (55% of L35); margin 3.64.
    - BOM: unit price, order qty, line total, lead time and check date;
    priced MISUMI items total KRW 184,128 ex VAT.
    - Ignore uncompressed vendor .step files and download zips.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
    [suspension_misumi.csv]
2026-11-14 feat(cad): Rev12b MISUMI STEP suspension detail, interference fixes, viewer BOM
    - Place the supplied MISUMI STEP for CLBKHM10 pins, MPFZ10-10 bushes and
    the new C-USLH10 urethane bump stopper (screwed into the arm, met by an
    M6 striker bolt). Springs use the STEP rectangular wire section/pitch.
    - Arm bush bores get 0.5x45 entry chamfers (bush R0.3 fillet); pin
    retainer thread drawn at the M6 tap minor diameter.
    - Add an all-pairs static check and per-wheel stroke-end checks (springs
    included) to --collisions. Fix the interferences they found: lower
    collar plates sank 1mm into the 3t base and enclosed the columns, LiDAR
    bridge crossed a main column, SICK optical envelope overlappe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
    [concept_bom.csv, suspension_misumi.csv]
2026-11-14 fix(bom): quote-safe MPFZ10-10 status and test BOM CSV totals
    An unquoted comma in the MPFZ10-10 status shifted its columns, so the
    viewer dropped that line from the MISUMI total. Add a test that every BOM
    row has the header width and that the total rows match the line sums.
    [suspension_misumi.csv]
2026-11-14 docs(suspension): record hinge vs vertical-travel review
    Quasi-static comparison from the Rev12b geometry: fore-aft step and slope
    forces are parallel to the hinge axis, so the hinge behaves like vertical
    travel in the direction of motion; the costs are lateral tilt, caster
    lateral shift and lateral-force load change. Vertical guides risk binding
    under traction because guide friction can exceed the spring load range.
    Keep the hinge; prototype step, ramp and cross-slope tests listed.
2026-11-14 feat(cad): Rev13 fastening and support review
    - Caster plate CB6-16 heads now bear on the 2 mm GL-65 plate measured
    from the OEM STEP (the 5 mm assumption left them 3 mm below it).
    - Remove the unfastened corner collar plates; all eight 2020 columns are
    bolted at both ends with CB5-12 into the tapped core (base and deck
    holes added).
    - Move the LiDAR support columns to X+-176/Y+-220 so the bridge clears
    the main column, and bolt the bridge to the support column.
    - Stand the electronics envelopes on M4 standoffs (computer on the PCB)
    and the battery on rubber pads; clamp the deck reinforcement with M8.
    - Seat each tilted camera on a printed wedge over a 90x74 adapter plate.
    - Add a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
    [concept_bom.csv, suspension_misumi.csv]
2026-11-14 feat(cad): Rev14 3t bend limit, column-mounted LiDAR bracket, bogie prep
    - Bending is limited to 3t: suspension arms become 3t bent channels and
    the hinge brackets 3t U; flat 8t bosses (bolted, CB4-10) give the
    MPFZ10-10 sleeves their press length and a flat 3t torque plate doubles
    the axle-flat bearing. Pins, springs and loads are unchanged.
    - Caster arms get a wide pad over the GL-65 plate so the 54 mm hole pitch
    keeps 7 mm edge distance (holes broke out of the arm edge before).
    - Fastener lengths end 2 mm past the nut (CB5-12, CB6-12); stopper gets an
    M5 nut under the 3t floor; caster seat spacer keeps the spring height.
    - LiDAR: a 3t bent bracket wraps two faces of the main col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
    [concept_bom.csv, suspension_misumi.csv]
